OzanE1/CCM7A/Modules/image.png

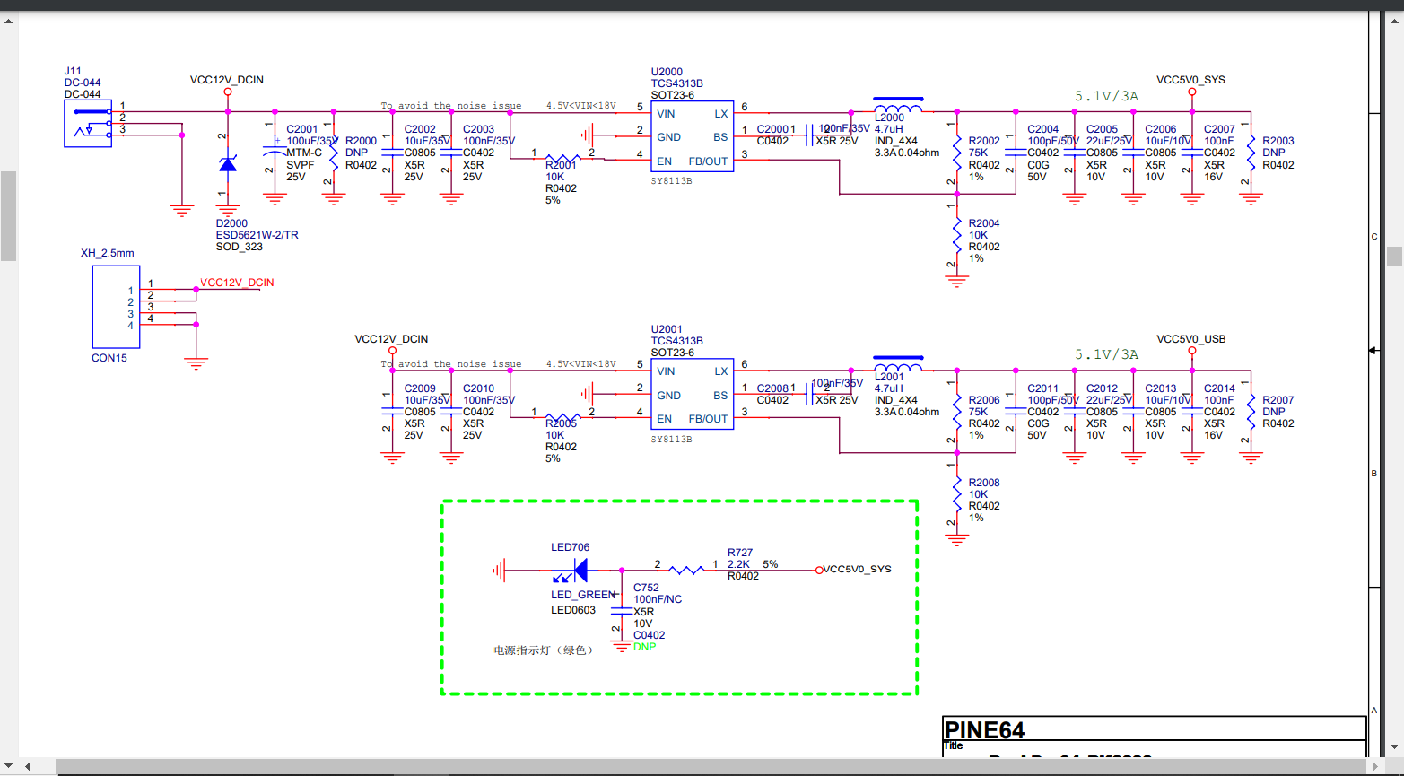
Modules/image.png
