OzanE1/CCM7A/CCM7A_BOM.xlsx

Comment | Designator | Footprint | Part Number
10uF | C1 | Capacitor_SMD:C_0402_1005Metric | C15525
10uF | C53 | Capacitor_SMD:C_0603_1608Metric | C96446
10uF | C34, C35 | Capacitor_SMD:C_0805_2012Metric | C15850
100nF | C2, C3, C4, C5,C6, C7,C8, C9, C10, C11, C12,C14, C16, C19, C22, C23, C24, C25, C33, C38, C41,C42, C43, C48, C52, C54, C55, C56, C57 | Capacitor_SMD:C_0402_1005Metric | C1525
100nF | C51 | Capacitor_SMD:C_0603_1608Metric | C1590
1uF | C13, C15, C36, C39 | Capacitor_SMD:C_0402_1005Metric | C15684
1uF | C30, C45, C46, C50 | Capacitor_SMD:C_0805_2012Metric | C28323
2.2uF | C17, C18 | Capacitor_SMD:C_0402_1005Metric | C12530
8pF | C20, C21, C32, C44 | Capacitor_SMD:C_0402_1005Metric | C1864375
22uF | C26, C27, C49, C60 | Capacitor_SMD:C_0805_2012Metric | C45783
2pF | C28 | Capacitor_SMD:C_0201_0603Metric | C88875
1pF | C29, C58, C61 | Capacitor_SMD:C_0201_0603Metric | C88903
100pF | C31 | Capacitor_SMD:C_0201_0603Metric | C62550
4.7uF | C40 | Capacitor_SMD:C_0603_1608Metric | C1705
33pF | C47 | Capacitor_SMD:C_0402_1005Metric | C107005
10nF | C59 | Capacitor_SMD:C_0402_1005Metric | C60133
1.2pF | C62 | Capacitor_SMD:C_0201_0603Metric | C85895
LED | D2 | LED_SMD:LED_0603_1608Metric | C84256
LED | D3 | LED_SMD:LED_0603_1608Metric | C2286
LED | D4 | LED_SMD:LED_0603_1608Metric | C2290
LED | D5 | LED_SMD:LED_0805_2012Metric | C2297
LED | D6 | LED_SMD:LED_0805_2012Metric | C2296
BAT60B | D9 | Diode_SMD:D_SOD-323 | C7502695
Polyfuse | F1 | Fuse:Fuse_0805_2012Metric | C914092
FerriteBead | FB1 | Inductor_SMD:L_0603_1608Metric | C1002
SRN6045TA-2R2Y | L1 | 6x6mmIND:IND_SRN6045TA-2R2Y | C1332316
4.7nH | L2 | Inductor_SMD:L_0201_0603Metric | C86126
2.2nH | L3 | Inductor_SMD:L_0201_0603Metric | C1329438
1.9nH | L6 | Inductor_SMD:L_0201_0603Metric | C206445
3.0nH | L7 | Inductor_SMD:L_0201_0603Metric | C86111
1.5k | R2, R7, R8, R9, R14, R17 | Resistor_SMD:R_0402_1005Metric | C25867
620R | R3 | Resistor_SMD:R_0402_1005Metric | C4961
4.7k | R1,R4, R5 | Resistor_SMD:R_0402_1005Metric | C25900
10k | R6, R11, R15 | Resistor_SMD:R_0402_1005Metric | C25744
100k | R10 | Resistor_SMD:R_0603_1608Metric | C25803
33.2k | R12 | Resistor_SMD:R_0603_1608Metric | C23003
220k | R13 | Resistor_SMD:R_0603_1608Metric | C22961
50R | R16 | Resistor_SMD:R_0402_1005Metric | C853312
30k | R18 | Resistor_SMD:R_0603_1608Metric | C22984
SKRPABE010 | S1 | SW_SKRPABE010:SW_SKRPABE010 | C115360
STM32H743VGTx | U1 | Package_QFP:LQFP-100_14x14mm_P0.5mm | C730183
24AA64T-I/OT | U2 | Package_TO_SOT_SMD:SOT-23-5_HandSoldering | C2061092
BMI088 | U3 | BMI088:PQFN50P450X300X100-16N | C194919
ICP-20100 | U4 | ICP-20100:PQFN50P200X200X85-10N | C5343527
TXB0104RUT | U5 | Package_DFN_QFN:Texas_R-PUQFN-N12 | C105266
nRF52820-QDxx | U6 | Package_DFN_QFN:QFN-40-1EP_5x5mm_P0.4mm_EP3.6x3.6mm | C3015612
NRF21540-QDAA-R7 | U7 | nRF21540:QFN65P400X400X95-17N | C5357827
TPS566242DRL | U8 | Package_TO_SOT_SMD:SOT-563 | C5219277
ME6211C33M5 | U9, U10 | Package_TO_SOT_SMD:SOT-23-5 | C82942
BMP581 | U11 | LGA-10(2x2) | C5362283
TPS79318-EP | U12 | Package_TO_SOT_SMD:SOT-23-5 | C7102
ICM-20948 | U13 | Sensor_Motion:InvenSense_QFN-24_3x3mm_P0.4mm | C726001
32MHz | Y1, Y2 | Crystal:Crystal_SMD_3225-4Pin_3.2x2.5mm | C426985
