OzanE1/CCM7A/CC_M7.pdf

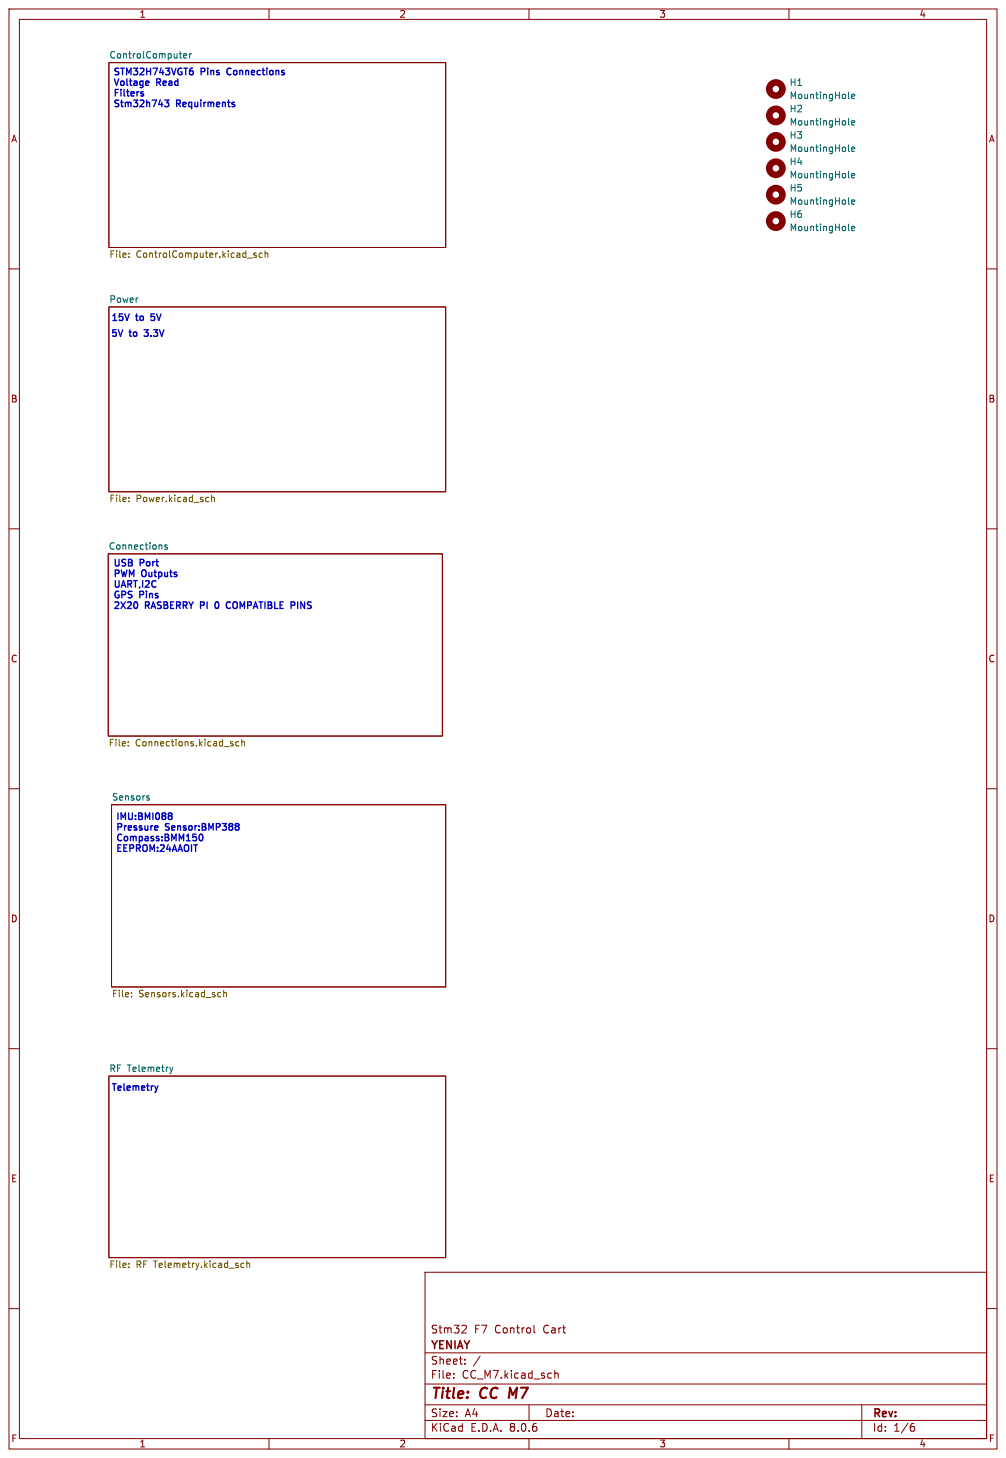
[picture p3: page 1]

STM32H743VGT6 Pins Connections Voltage Read

5V to 3.3V USB Port PWM Outputs
Sensors File: Sensors.kicad_sch Connections File: Connections.kicad_sch

2X20 RASBERRY PI 0 COMPATIBLE PINS

IMU:BMI088 Pressure Sensor:BMP388 Compass:BMM150 EEPROM:24AAOIT

Stm32 F7 Control Cart RF Telemetry File: RF Telemetry.kicad_sch
Telemetry

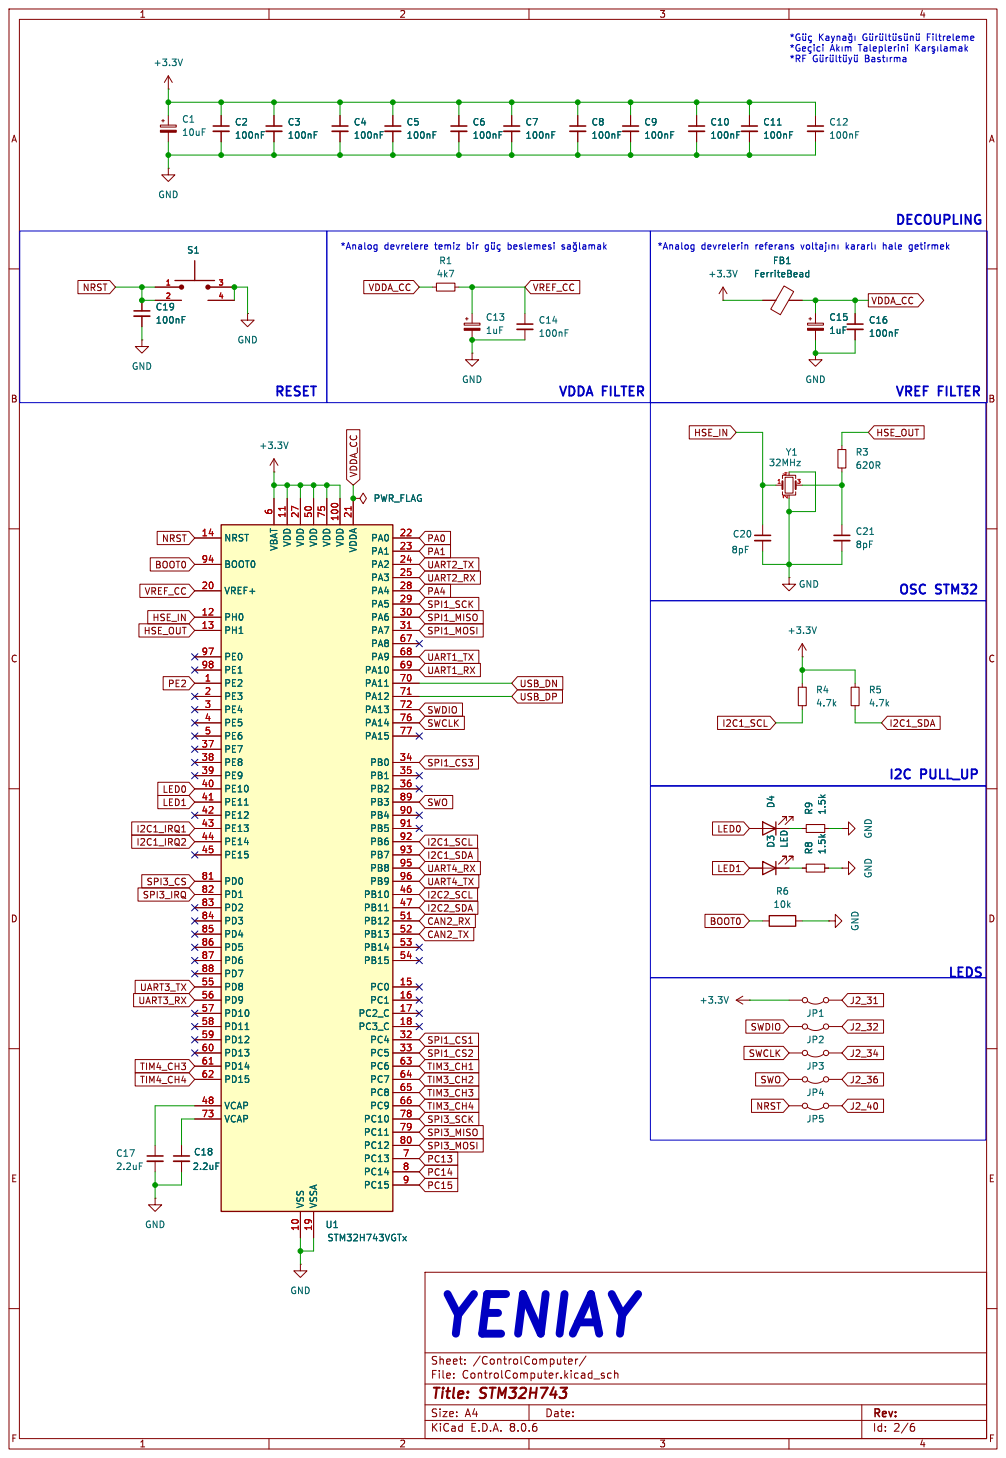
[picture p4: page 2]

þÿ*Güç þÿKayna1 þÿGürültüsünü Filtreleme

File: ControlComputer.kicad_sch Sheet: /ControlComputer/
Id: 2/6 Title: STM32H743

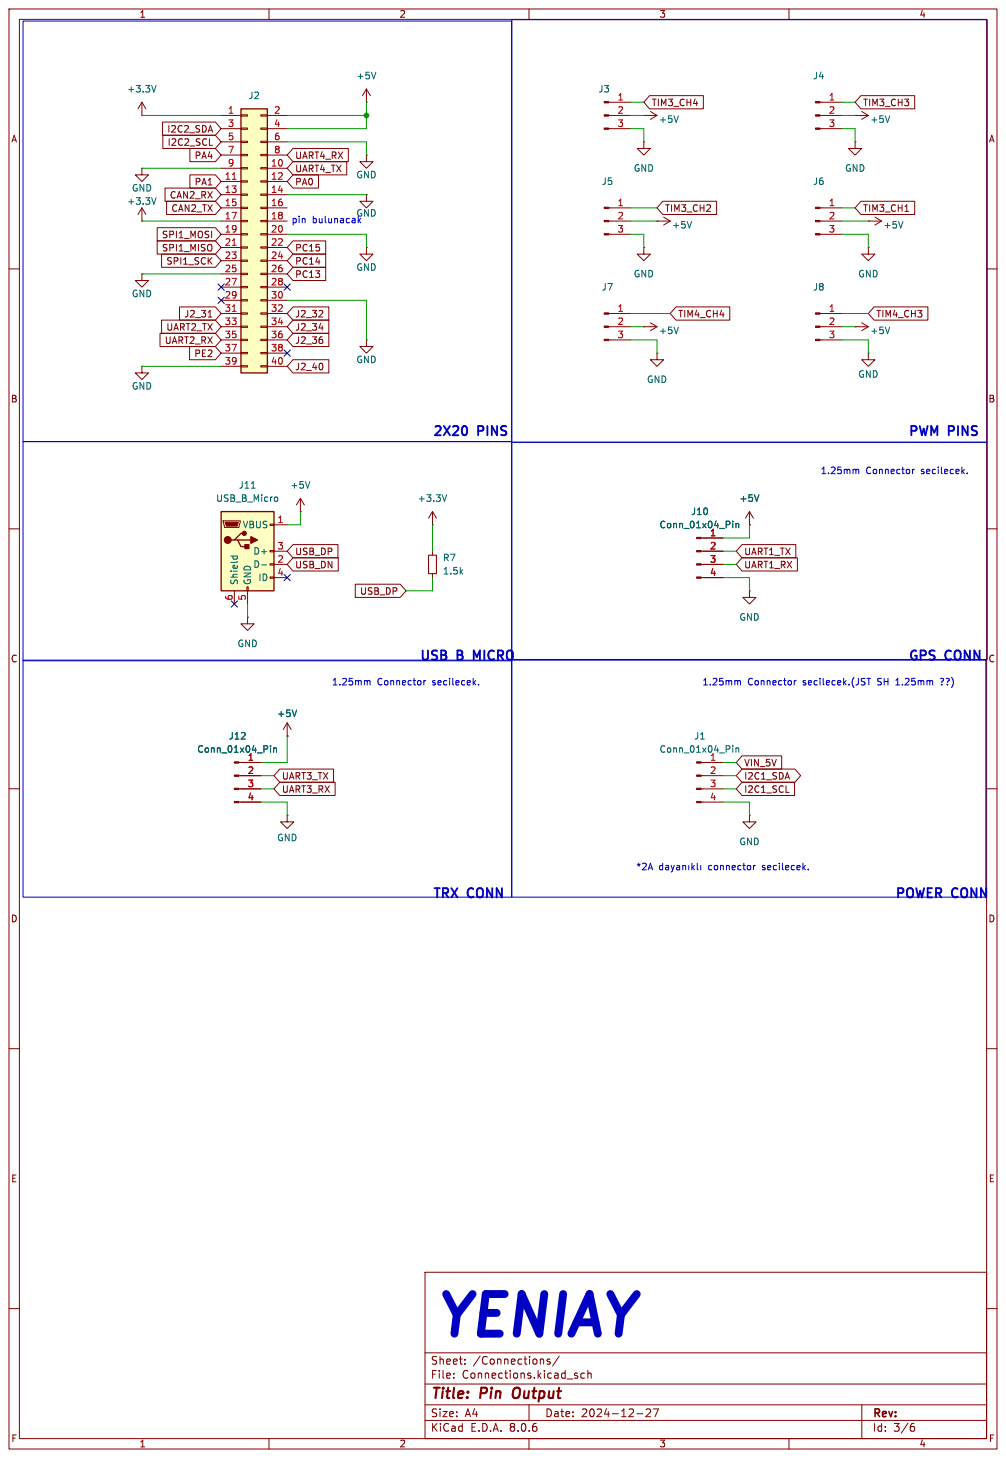
[picture p5: page 3]

Id: 3/6 Title: Pin Output File: Connections.kicad_sch Sheet: /Connections/

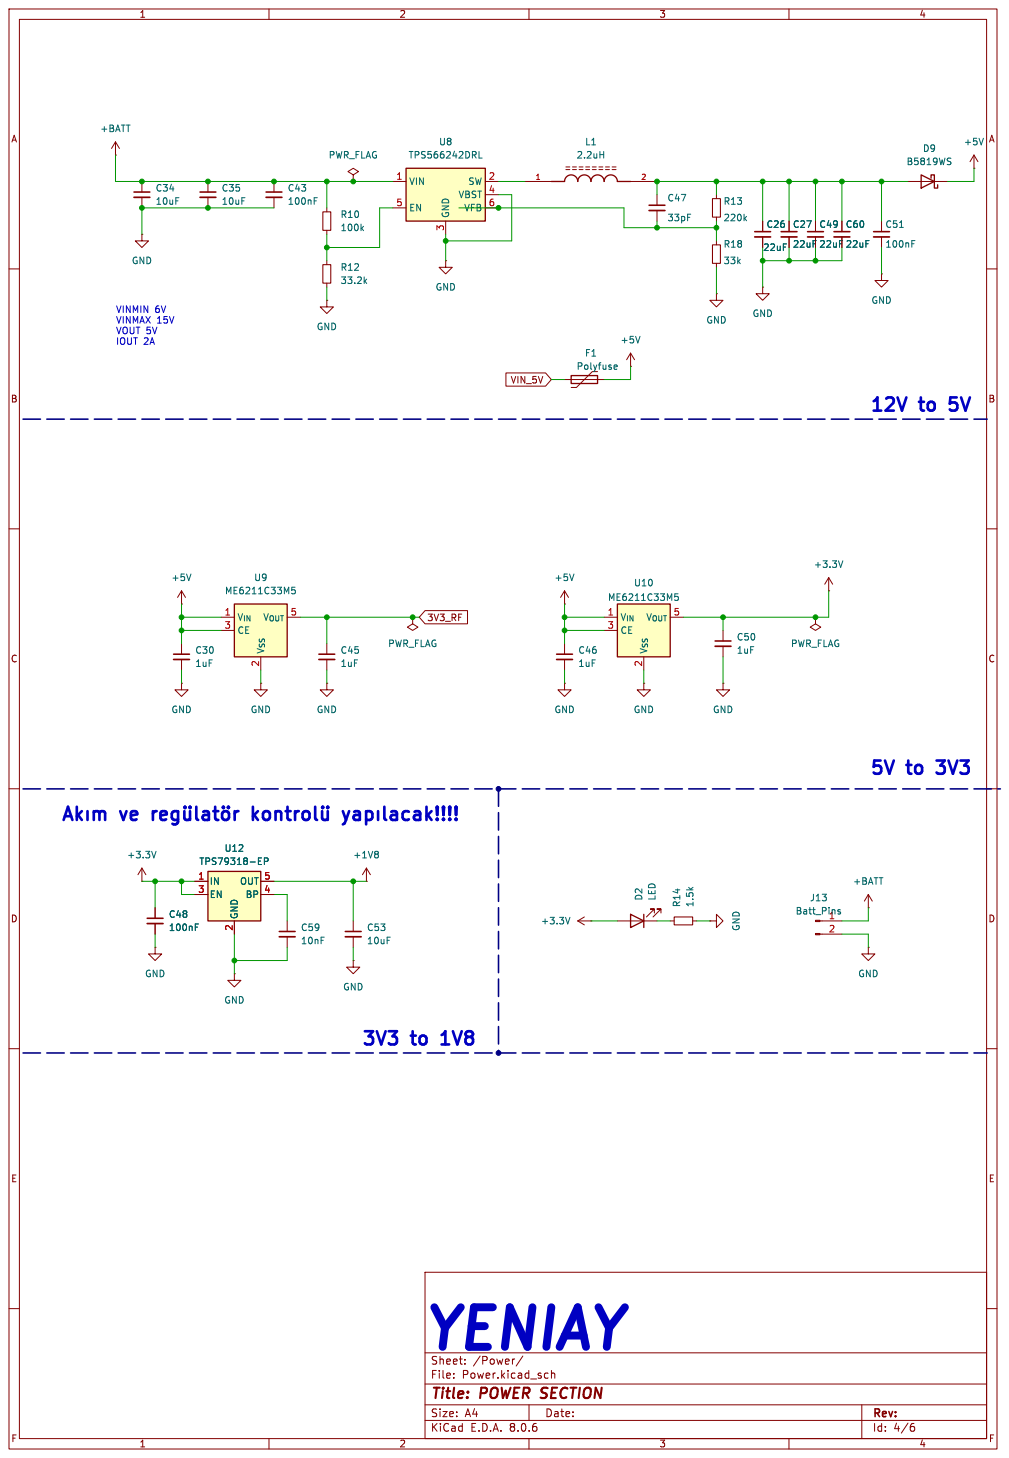
[picture p6: page 4]

2 EN 3 BP 4 OUT 5 U12 TPS79318-EP

Id: 4/6 Title: POWER SECTION

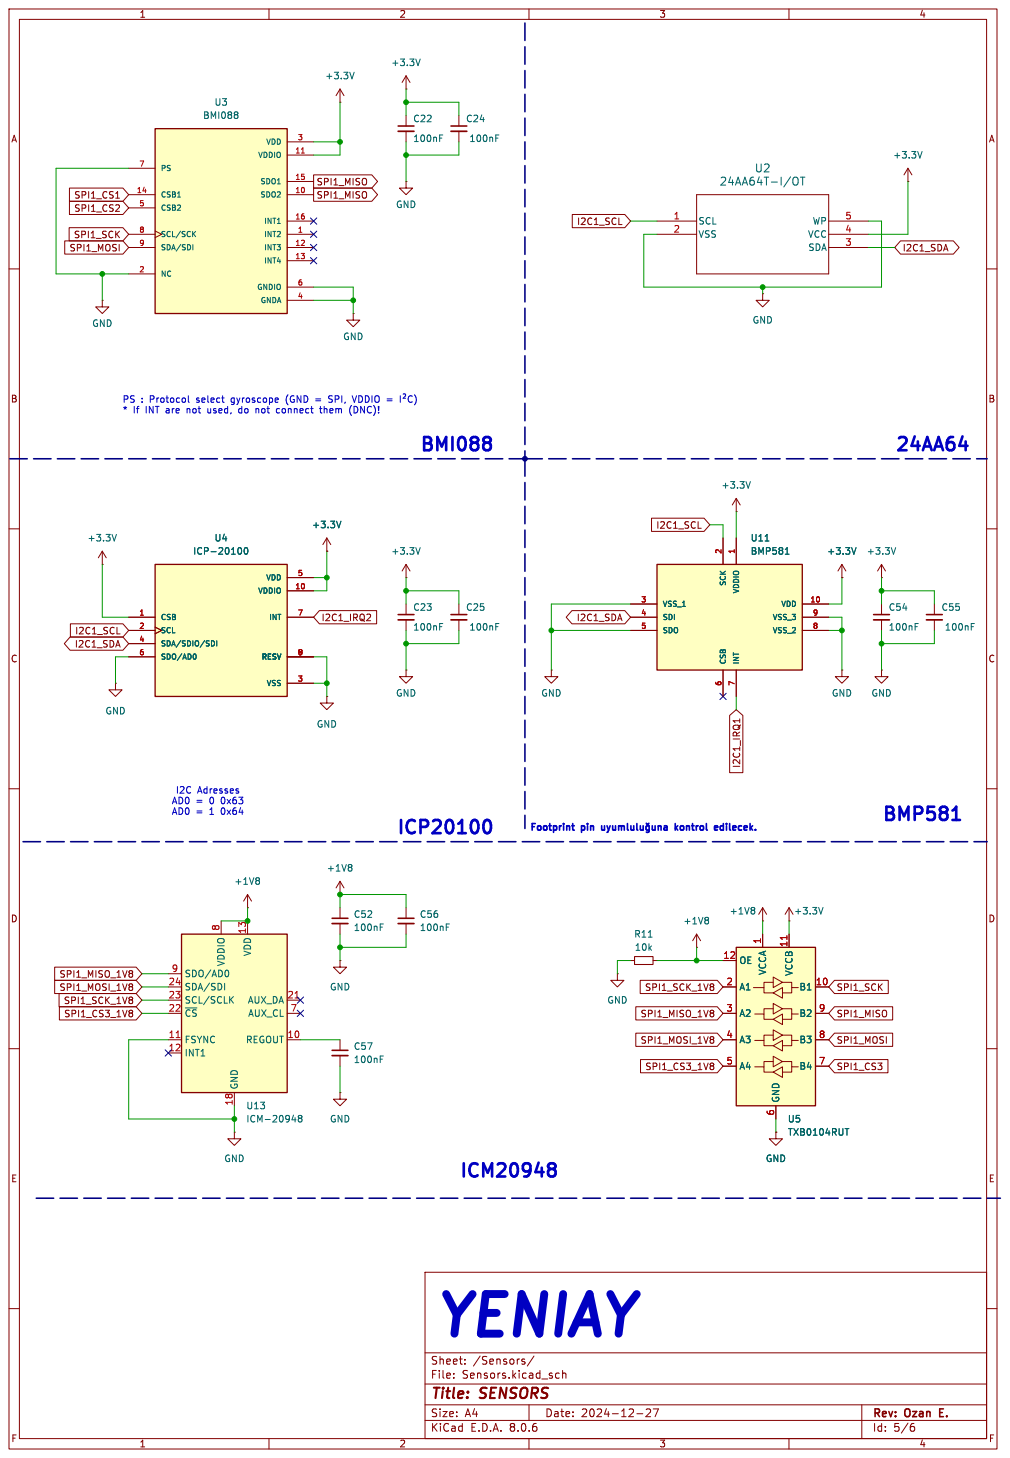
[picture p7: page 5]

Footprint pin þÿuyumluluuna kotrol edilecek. U4

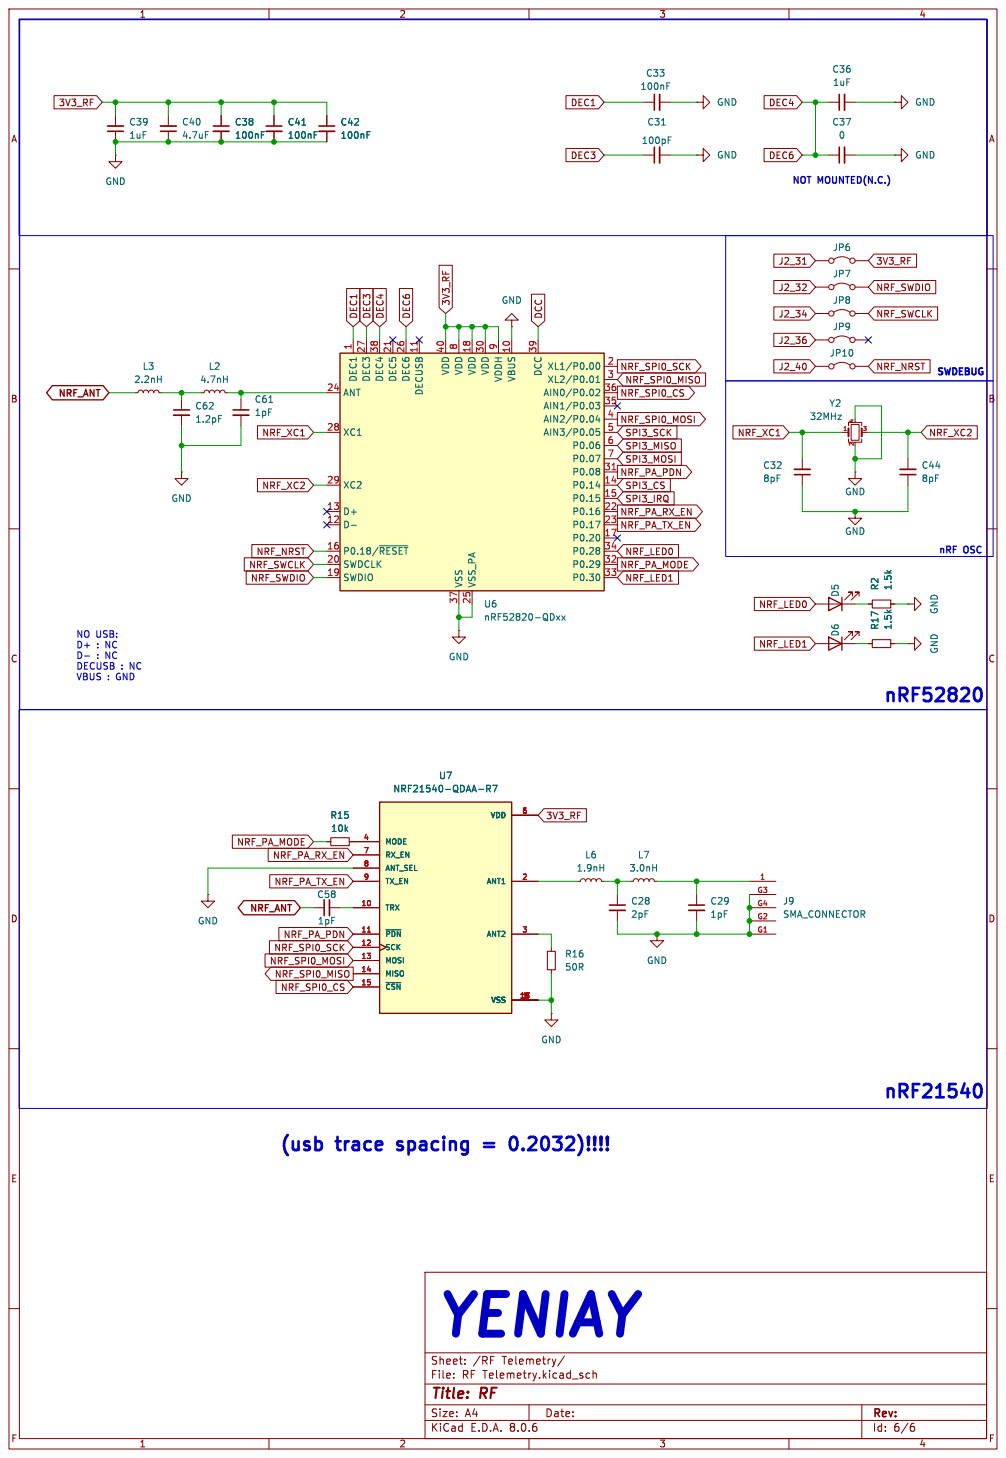
[picture p8: page 6]

1 VBUS 10 DECUSB 11 D- 12 D+ 13 P0.14 14 P0.15 15 P0.18/~{RESET} 16 P0.20 17 VDD 18 SWDIO 19 XL1/P0.00 2 SWDCLK 20 DEC5 21 P0.16 22 P0.17 23 ANT 24 VSS_PA 25 DEC6 26 DEC3 27 XC1 28 XC2 29 XL2/P0.01 VDD 3 30 P0.08 31 P0.29 32 P0.30 33 P0.28 34 AIN1/P0.03 35 AIN0/P0.02 36 VSS 37 DEC4 38 DCC 39 AIN2/P0.04 4 VDD 40 AIN3/P0.05 5 P0.06 6 P0.07 7 VDD
