OzanE1/CCM7A/CC_M7/CC_M7.kicad_pcb

## KiCad design CC_M7/CC_M7.kicad_pcb (2025-06-05)

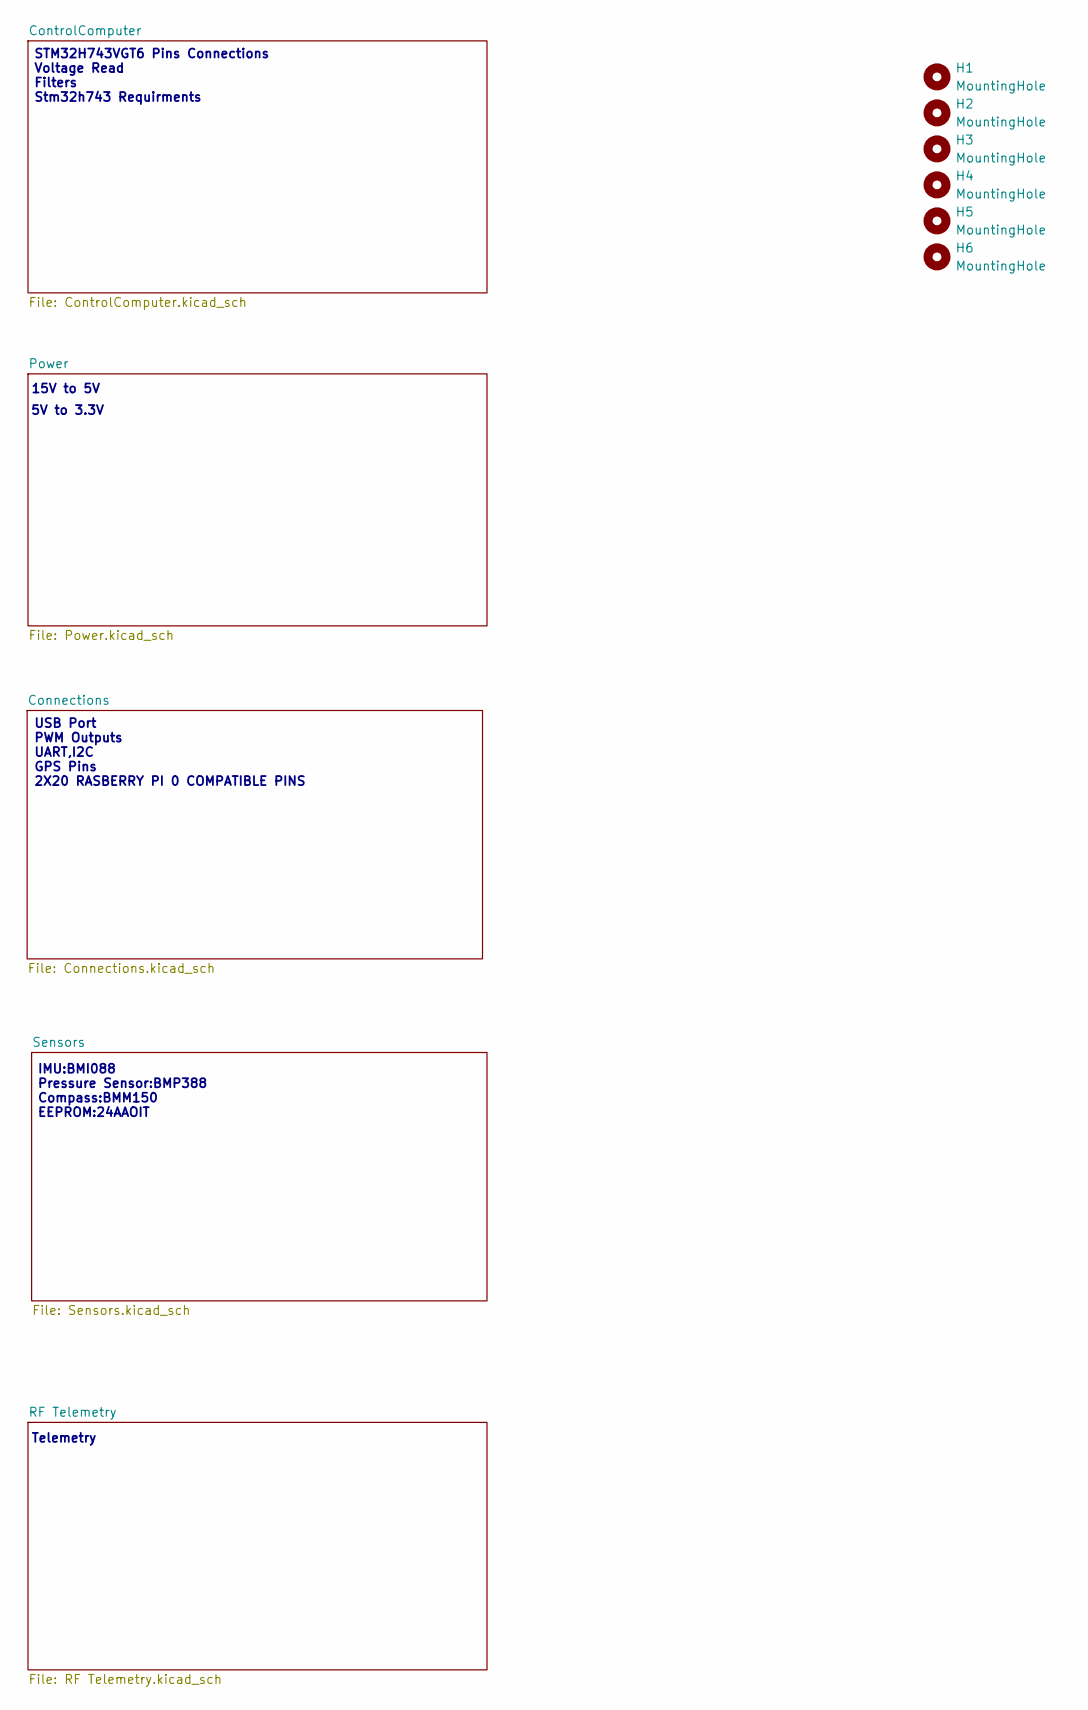
[picture p9: schematic CC_M7.kicad_sch, CC M7]

Parts:
H1, H2, H3, H4, H5, H6: MountingHole; CCMountingHole

Notes on the sheet:
15V to 5V
5V to 3.3V
USB Port PWM Outputs UART,I2C GPS Pins 2X20 RASBERRY PI 0 COMPATIBLE PINS
Telemetry
STM32H743VGT6 Pins Connections Voltage Read Filters Stm32h743 Requirments
IMU:BMI088 Pressure Sensor:BMP388 Compass:BMM150 EEPROM:24AAOIT

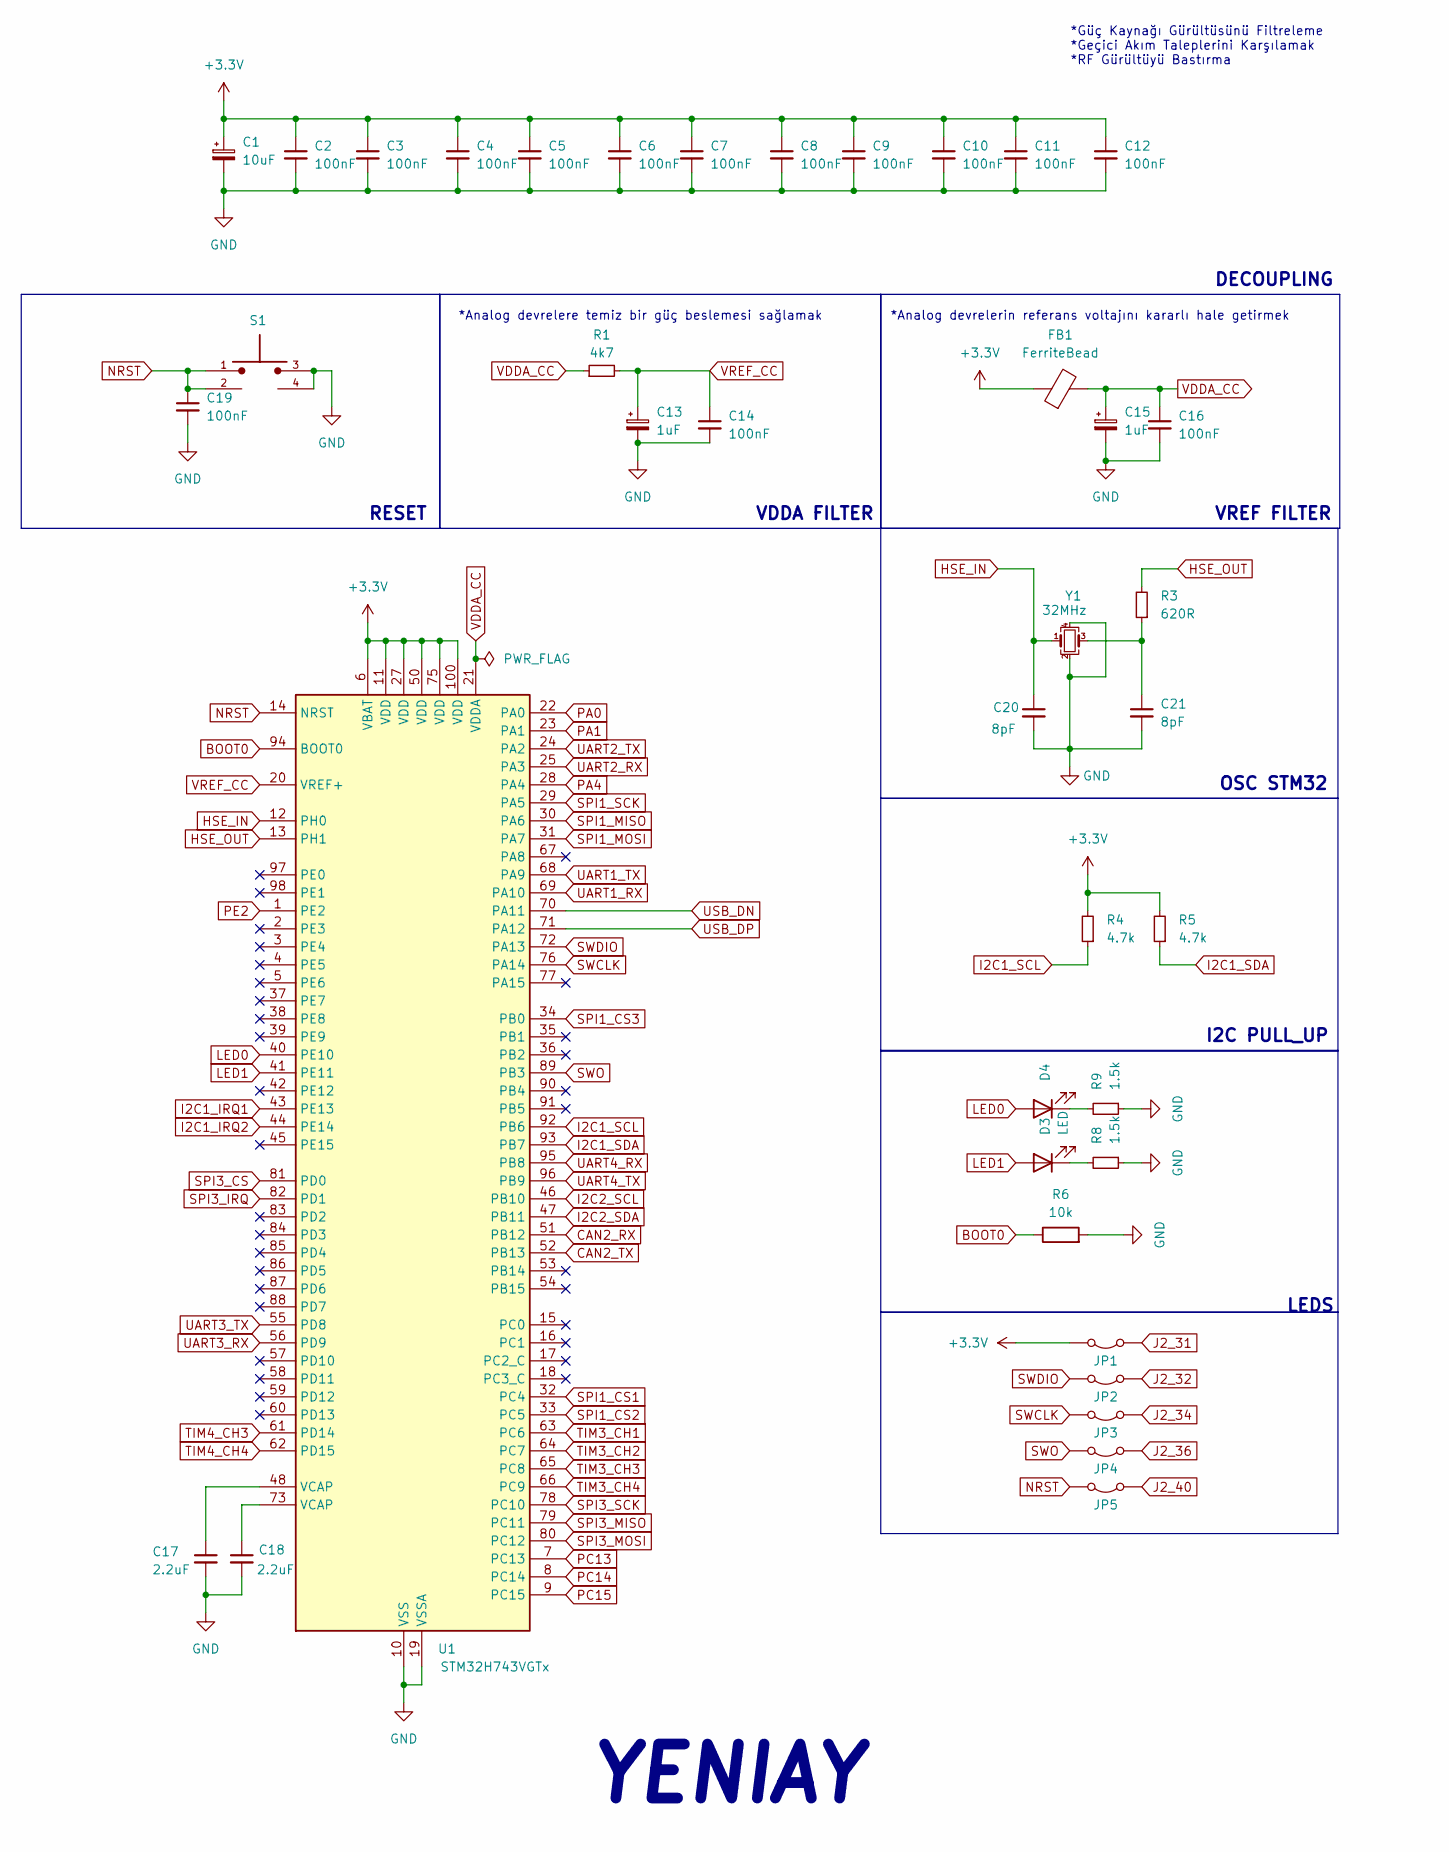
[picture p10: schematic ControlComputer.kicad_sch, STM32H743]

Parts:
C1: 10uF; C_0402_1005Metric
C2, C3, C4, C5, C6, C7, C8, C9, C10, C11, C12, C14, C16, C19: 100nF; C_0402_1005Metric
C13, C15: 1uF; C_0402_1005Metric
C17, C18: 2.2uF; C_0402_1005Metric
C20, C21: 8pF; C_0402_1005Metric
D3, D4: LED; LED_0603_1608Metric
FB1: FerriteBead; L_0603_1608Metric
JP1, JP2, JP3, JP4, JP5: SWDIO; SolderJumper-2_P1.3mm_Open_TrianglePad1.0x1.5mm
R1: 4k7; R_0402_1005Metric
R3: 620R; R_0402_1005Metric
R4, R5: 4.7k; R_0402_1005Metric
R6: 10k; R_0402_1005Metric
R8, R9: 1.5k; R_0402_1005Metric
S1: SKRPABE010; SW_SKRPABE010
U1: STM32H743VGTx; LQFP-100_14x14mm_P0.5mm
Y1: 32MHz; Crystal_SMD_3225-4Pin_3.2x2.5mm

Connections:
+3.3V: C1.1, C2.1, C3.1, C4.1, C5.1, C6.1, C7.1, C8.1, C9.1, C10.1, C11.1, C12.1, FB1.1, JP1.2 (B), R4.2, R5.2, U1.6 (VBAT), U1.11 (VDD), U1.27 (VDD), U1.50 (VDD), U1.75 (VDD), U1.100 (VDD); also elsewhere on the board
BOOT0: R6.1, U1.94 (BOOT0)
CAN2_RX: U1.51 (PB12); also elsewhere on the board
CAN2_TX: U1.52 (PB13); also elsewhere on the board
GND: C1.2, C2.2, C3.2, C4.2, C5.2, C6.2, C7.2, C8.2, C9.2, C10.2, C11.2, C12.2, C13.2, C14.2, C15.2, C16.2, C17.2, C18.2, C19.2, C20.2, C21.2, R6.2, R8.1, R9.1, S1.3, S1.4, U1.10 (VSS), U1.19 (VSSA), U1.26 (VSS), U1.49 (VSS), U1.74 (VSS), U1.99 (VSS), Y1.2, Y1.4; also elsewhere on the board
HSE_IN: C20.1, U1.12 (PH0), Y1.1
HSE_OUT: R3.2, U1.13 (PH1)
I2C1_IRQ1: U1.43 (PE13); also elsewhere on the board
I2C1_IRQ2: U1.44 (PE14); also elsewhere on the board
I2C1_SCL: R4.1, U1.92 (PB6); also elsewhere on the board
I2C1_SDA: R5.1, U1.93 (PB7); also elsewhere on the board
I2C2_SCL: U1.46 (PB10); also elsewhere on the board
I2C2_SDA: U1.47 (PB11); also elsewhere on the board
J2_31: JP1.1 (A); also elsewhere on the board
J2_32: JP2.1 (A); also elsewhere on the board
J2_34: JP3.1 (A); also elsewhere on the board
J2_36: JP4.1 (A); also elsewhere on the board
J2_40: JP5.1 (A); also elsewhere on the board
LED0: D4.2 (A), U1.40 (PE10)
LED1: D3.2 (A), U1.41 (PE11)
NRST: C19.1, JP5.2 (B), S1.1, S1.2, U1.14 (NRST)
unnamed: C17.1, U1.48 (VCAP)
unnamed: C18.1, U1.73 (VCAP)
unnamed: C21.1, R3.1, Y1.3
unnamed: D3.1 (K), R8.2
unnamed: D4.1 (K), R9.2
PA0: U1.22 (PA0); also elsewhere on the board
PA1: U1.23 (PA1); also elsewhere on the board
PA4: U1.28 (PA4); also elsewhere on the board
PC13: U1.7 (PC13); also elsewhere on the board
PC14: U1.8 (PC14); also elsewhere on the board
PC15: U1.9 (PC15); also elsewhere on the board
PE2: U1.1 (PE2); also elsewhere on the board
SPI1_CS1: U1.32 (PC4); also elsewhere on the board
SPI1_CS2: U1.33 (PC5); also elsewhere on the board
SPI1_CS3: U1.34 (PB0); also elsewhere on the board
SPI1_MISO: U1.30 (PA6); also elsewhere on the board
SPI1_MOSI: U1.31 (PA7); also elsewhere on the board
SPI1_SCK: U1.29 (PA5); also elsewhere on the board
SPI3_CS: U1.81 (PD0); also elsewhere on the board
SPI3_IRQ: U1.82 (PD1); also elsewhere on the board
SPI3_MISO: U1.79 (PC11); also elsewhere on the board
SPI3_MOSI: U1.80 (PC12); also elsewhere on the board
SPI3_SCK: U1.78 (PC10); also elsewhere on the board
SWCLK: JP3.2 (B), U1.76 (PA14)
SWDIO: JP2.2 (B), U1.72 (PA13)
SWO: JP4.2 (B), U1.89 (PB3)
TIM3_CH1: U1.63 (PC6); also elsewhere on the board
TIM3_CH2: U1.64 (PC7); also elsewhere on the board
TIM3_CH3: U1.65 (PC8); also elsewhere on the board
TIM3_CH4: U1.66 (PC9); also elsewhere on the board
TIM4_CH3: U1.61 (PD14); also elsewhere on the board
TIM4_CH4: U1.62 (PD15); also elsewhere on the board
UART1_RX: U1.69 (PA10); also elsewhere on the board
UART1_TX: U1.68 (PA9); also elsewhere on the board
UART2_RX: U1.25 (PA3); also elsewhere on the board
UART2_TX: U1.24 (PA2); also elsewhere on the board
UART3_RX: U1.56 (PD9); also elsewhere on the board
UART3_TX: U1.55 (PD8); also elsewhere on the board
UART4_RX: U1.95 (PB8); also elsewhere on the board
UART4_TX: U1.96 (PB9); also elsewhere on the board
USB_DN: U1.70 (PA11); also elsewhere on the board
USB_DP: U1.71 (PA12); also elsewhere on the board
VDDA_CC: C15.1, C16.1, FB1.2, R1.1, U1.21 (VDDA)
VREF_CC: C13.1, C14.1, R1.2, U1.20 (VREF+)

Notes on the sheet:
*Güç Kaynağı Gürültüsünü Filtreleme *Geçici Akım Taleplerini Karşılamak *RF Gürültüyü Bastırma
*Analog devrelere temiz bir güç beslemesi sağlamak
DECOUPLING
OSC STM32
VREF FILTER
RESET
I2C PULL_UP
*Analog devrelerin referans voltajını kararlı hale getirmek
LEDS
YENIAY
VDDA FILTER

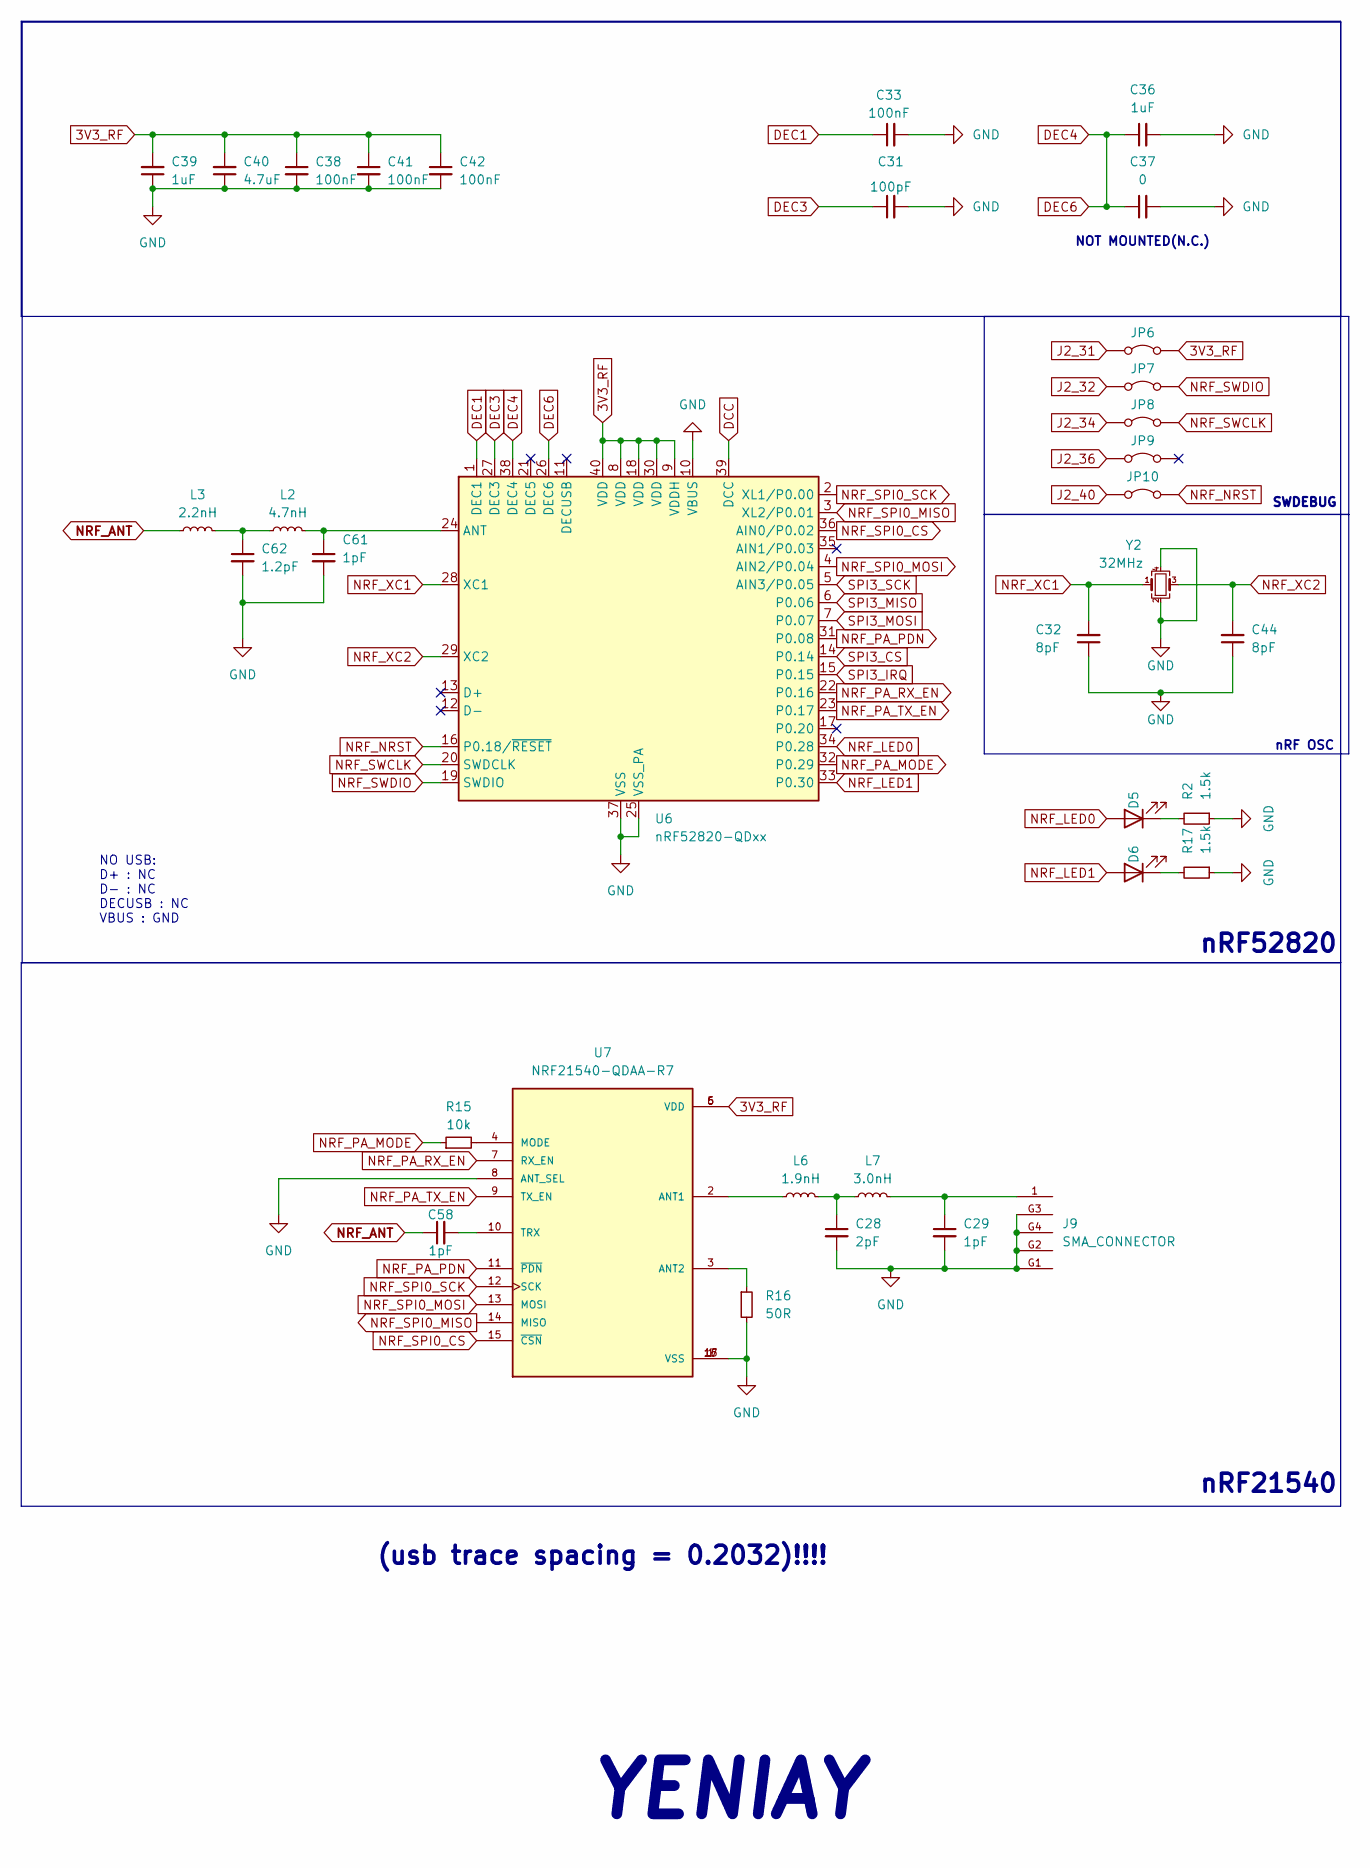
[picture p11: schematic RF Telemetry.kicad_sch, RF]

Parts:
C28: 2pF; C_0201_0603Metric
C29, C58, C61: 1pF; C_0201_0603Metric
C31: 100pF; C_0402_1005Metric
C32, C44: 8pF; C_0402_1005Metric
C33, C38, C41, C42: 100nF; C_0402_1005Metric
C36, C39: 1uF; C_0402_1005Metric
C37: 0; C_0402_1005Metric
C40: 4.7uF; C_0603_1608Metric
C62: 1.2pF; C_0201_0603Metric
D5, D6: LED; LED_0805_2012Metric
J9: SMA_CONNECTOR; LPRS_SMA_CONNECTOR; PARTREV 1.3
JP6, JP7, JP8, JP9, JP10: SWDIO; SolderJumper-2_P1.3mm_Open_TrianglePad1.0x1.5mm
L2: 4.7nH; L_0201_0603Metric
L3: 2.2nH; L_0201_0603Metric
L6: 1.9nH; L_0201_0603Metric
L7: 3.0nH; L_0201_0603Metric
R2, R17: 1.5k; R_0402_1005Metric
R15: 10k; R_0402_1005Metric
R16: 50R; R_0402_1005Metric
U6: nRF52820-QDxx; QFN-40-1EP_5x5mm_P0.4mm_EP3.6x3.6mm
U7: NRF21540-QDAA-R7; QFN65P400X400X95-17N; PARTREV 1.0
Y2: 32MHz; Crystal_SMD_3225-4Pin_3.2x2.5mm

Connections:
3V3_RF: C38.1, C39.2, C40.2, C41.1, C42.1, JP6.2 (B), U6.8 (VDD), U6.9 (VDDH), U6.18 (VDD), U6.30 (VDD), U6.40 (VDD), U7.5 (VDD), U7.6 (VDD); also elsewhere on the board
DCC: U6.39 (DCC)
DEC1: C33.1, U6.1 (DEC1)
DEC3: C31.1, U6.27 (DEC3)
DEC4: C36.1, C37.1, U6.26 (DEC6), U6.38 (DEC4)
GND: C28.2, C29.2, C31.2, C32.1, C33.2, C36.2, C37.2, C38.2, C39.1, C40.1, C41.2, C42.2, C44.1, C61.2, C62.2, J9.G1, J9.G2, J9.G3, J9.G4, R2.1, R16.2, R17.1, U6.10 (VBUS), U6.25 (VSS_PA), U6.37 (VSS), U6.41 (VSS), U7.1 (VSS), U7.8 (ANT_SEL), U7.16 (VSS), U7.17 (VSS), Y2.2, Y2.4; also elsewhere on the board
J2_31: JP6.1 (A); also elsewhere on the board
J2_32: JP7.1 (A); also elsewhere on the board
J2_34: JP8.1 (A); also elsewhere on the board
J2_36: JP9.1 (A); also elsewhere on the board
J2_40: JP10.1 (A); also elsewhere on the board
NRF_ANT: C58.1, L3.1
NRF_LED0: D5.2 (A), U6.34 (P0.28)
NRF_LED1: D6.2 (A), U6.33 (P0.30)
NRF_NRST: JP10.2 (B), U6.16 (P0.18/~RESET)
NRF_PA_MODE: R15.1, U6.32 (P0.29)
NRF_PA_PDN: U6.31 (P0.08), U7.11 (~PDN)
NRF_PA_RX_EN: U6.22 (P0.16), U7.7 (RX_EN)
NRF_PA_TX_EN: U6.23 (P0.17), U7.9 (TX_EN)
NRF_SPI0_CS: U6.36 (AIN0/P0.02), U7.15 (~CSN)
NRF_SPI0_MISO: U6.3 (XL2/P0.01), U7.14 (MISO)
NRF_SPI0_MOSI: U6.4 (AIN2/P0.04), U7.13 (MOSI)
NRF_SPI0_SCK: U6.2 (XL1/P0.00), U7.12 (SCK)
NRF_SWCLK: JP8.2 (B), U6.20 (SWDCLK)
NRF_SWDIO: JP7.2 (B), U6.19 (SWDIO)
NRF_XC1: C32.2, U6.28 (XC1), Y2.1
NRF_XC2: C44.2, U6.29 (XC2), Y2.3
unnamed: C28.1, L6.2, L7.1
unnamed: C29.1, J9.1, L7.2
unnamed: C62.1, L2.1, L3.2
unnamed: D5.1 (K), R2.2
unnamed: D6.1 (K), R17.2
unnamed: C61.1, L2.2, U6.24 (ANT)
unnamed: L6.1, U7.2 (ANT1)
unnamed: R16.1, U7.3 (ANT2)
unnamed: R15.2, U7.4 (MODE)
unnamed: C58.2, U7.10 (TRX)
SPI3_CS: U6.14 (P0.14); also elsewhere on the board
SPI3_IRQ: U6.15 (P0.15); also elsewhere on the board
SPI3_MISO: U6.6 (P0.06); also elsewhere on the board
SPI3_MOSI: U6.7 (P0.07); also elsewhere on the board
SPI3_SCK: U6.5 (AIN3/P0.05); also elsewhere on the board

Notes on the sheet:
NO USB: D+ : NC D- : NC DECUSB : NC VBUS : GND
(usb trace spacing = 0.2032)!!!!
nRF21540
nRF52820
YENIAY
NOT MOUNTED(N.C.)
nRF OSC
SWDEBUG

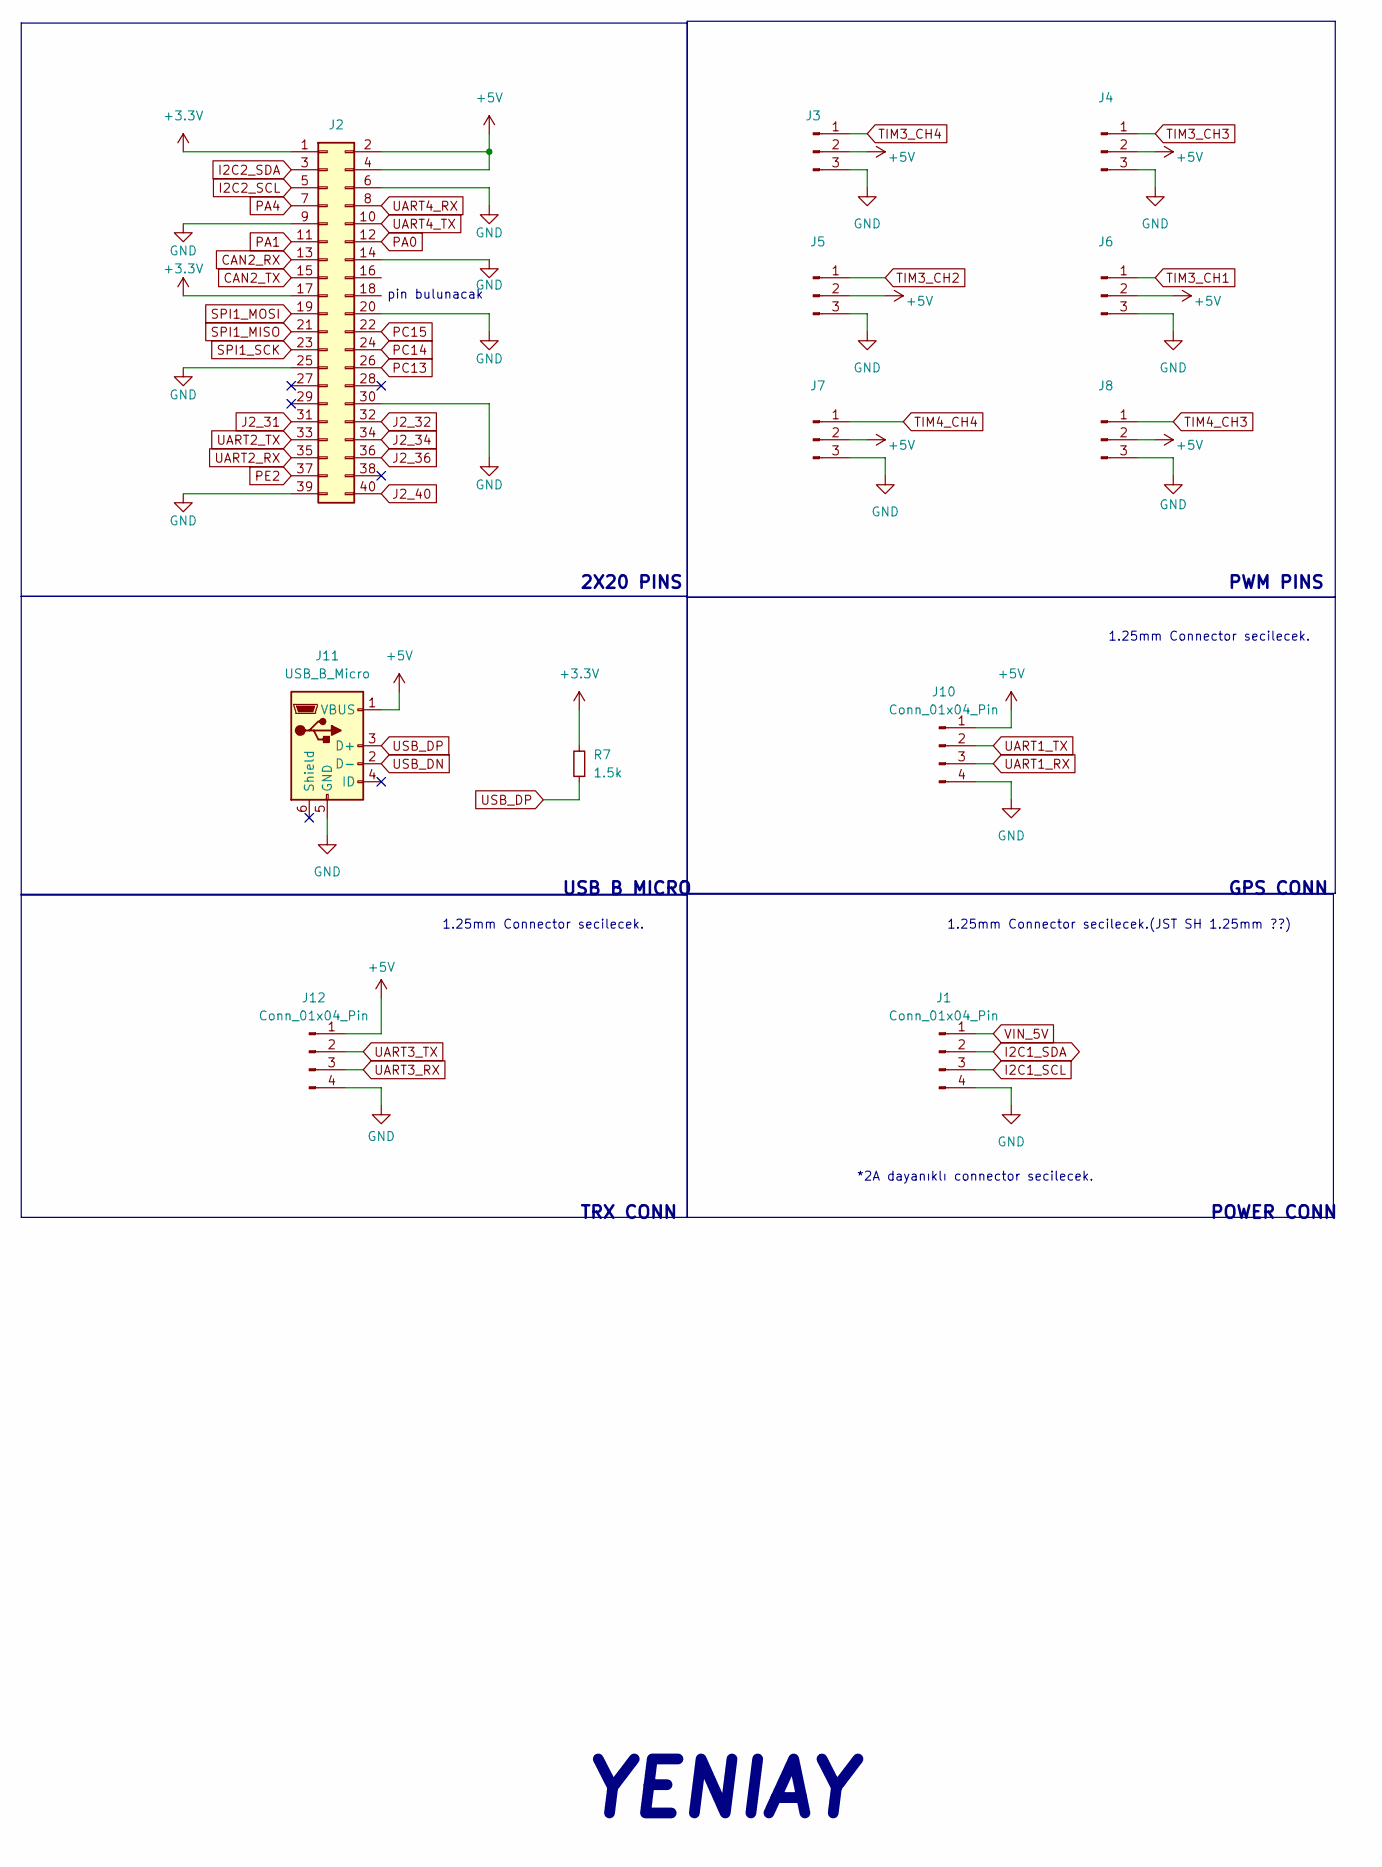
[picture p12: schematic Connections.kicad_sch, Pin Output]

Parts:
J1, J10, J12: Conn_01x04_Pin; Hirose_DF13-04P-1.25DSA_1x04_P1.25mm_Vertical
J2: IDC-Header_2x20_P2.54mm_Vertical
J3, J4, J5, J6, J7, J8: Conn_01x03_Pin; 1x03_2.54vertical
J11: USB_B_Micro; USB_Micro-B_Wuerth_629105150521
R7: 1.5k; R_0402_1005Metric

Connections:
+3.3V: J2.1, J2.17, R7.2; also elsewhere on the board
+5V: J2.2, J2.4, J3.2, J4.2, J5.2, J6.2, J7.2, J8.2, J10.1, J11.1 (VBUS), J12.1; also elsewhere on the board
CAN2_RX: J2.13; also elsewhere on the board
CAN2_TX: J2.15; also elsewhere on the board
GND: J1.4, J2.6, J2.9, J2.14, J2.20, J2.25, J2.30, J2.39, J3.3, J4.3, J5.3, J6.3, J7.3, J8.3, J10.4, J11.5 (GND), J12.4; also elsewhere on the board
I2C1_SCL: J1.3; also elsewhere on the board
I2C1_SDA: J1.2; also elsewhere on the board
I2C2_SCL: J2.5; also elsewhere on the board
I2C2_SDA: J2.3; also elsewhere on the board
J2_31: J2.31; also elsewhere on the board
J2_32: J2.32; also elsewhere on the board
J2_34: J2.34; also elsewhere on the board
J2_36: J2.36; also elsewhere on the board
J2_40: J2.40; also elsewhere on the board
PA0: J2.12; also elsewhere on the board
PA1: J2.11; also elsewhere on the board
PA4: J2.7; also elsewhere on the board
PC13: J2.26; also elsewhere on the board
PC14: J2.24; also elsewhere on the board
PC15: J2.22; also elsewhere on the board
PE2: J2.37; also elsewhere on the board
SPI1_MISO: J2.21; also elsewhere on the board
SPI1_MOSI: J2.19; also elsewhere on the board
SPI1_SCK: J2.23; also elsewhere on the board
TIM3_CH1: J6.1; also elsewhere on the board
TIM3_CH2: J5.1; also elsewhere on the board
TIM3_CH3: J4.1; also elsewhere on the board
TIM3_CH4: J3.1; also elsewhere on the board
TIM4_CH3: J8.1; also elsewhere on the board
TIM4_CH4: J7.1; also elsewhere on the board
UART1_RX: J10.3; also elsewhere on the board
UART1_TX: J10.2; also elsewhere on the board
UART2_RX: J2.35; also elsewhere on the board
UART2_TX: J2.33; also elsewhere on the board
UART3_RX: J12.3; also elsewhere on the board
UART3_TX: J12.2; also elsewhere on the board
UART4_RX: J2.8; also elsewhere on the board
UART4_TX: J2.10; also elsewhere on the board
USB_DN: J11.2 (D-); also elsewhere on the board
USB_DP: J11.3 (D+), R7.1; also elsewhere on the board
VIN_5V: J1.1; also elsewhere on the board

Notes on the sheet:
YENIAY
POWER CONN
pin bulunacak
PWM PINS
GPS CONN
1.25mm Connector secilecek.
*2A dayanıklı connector secilecek.
TRX CONN
2X20 PINS
1.25mm Connector secilecek.(JST SH 1.25mm ??)
USB B MICRO

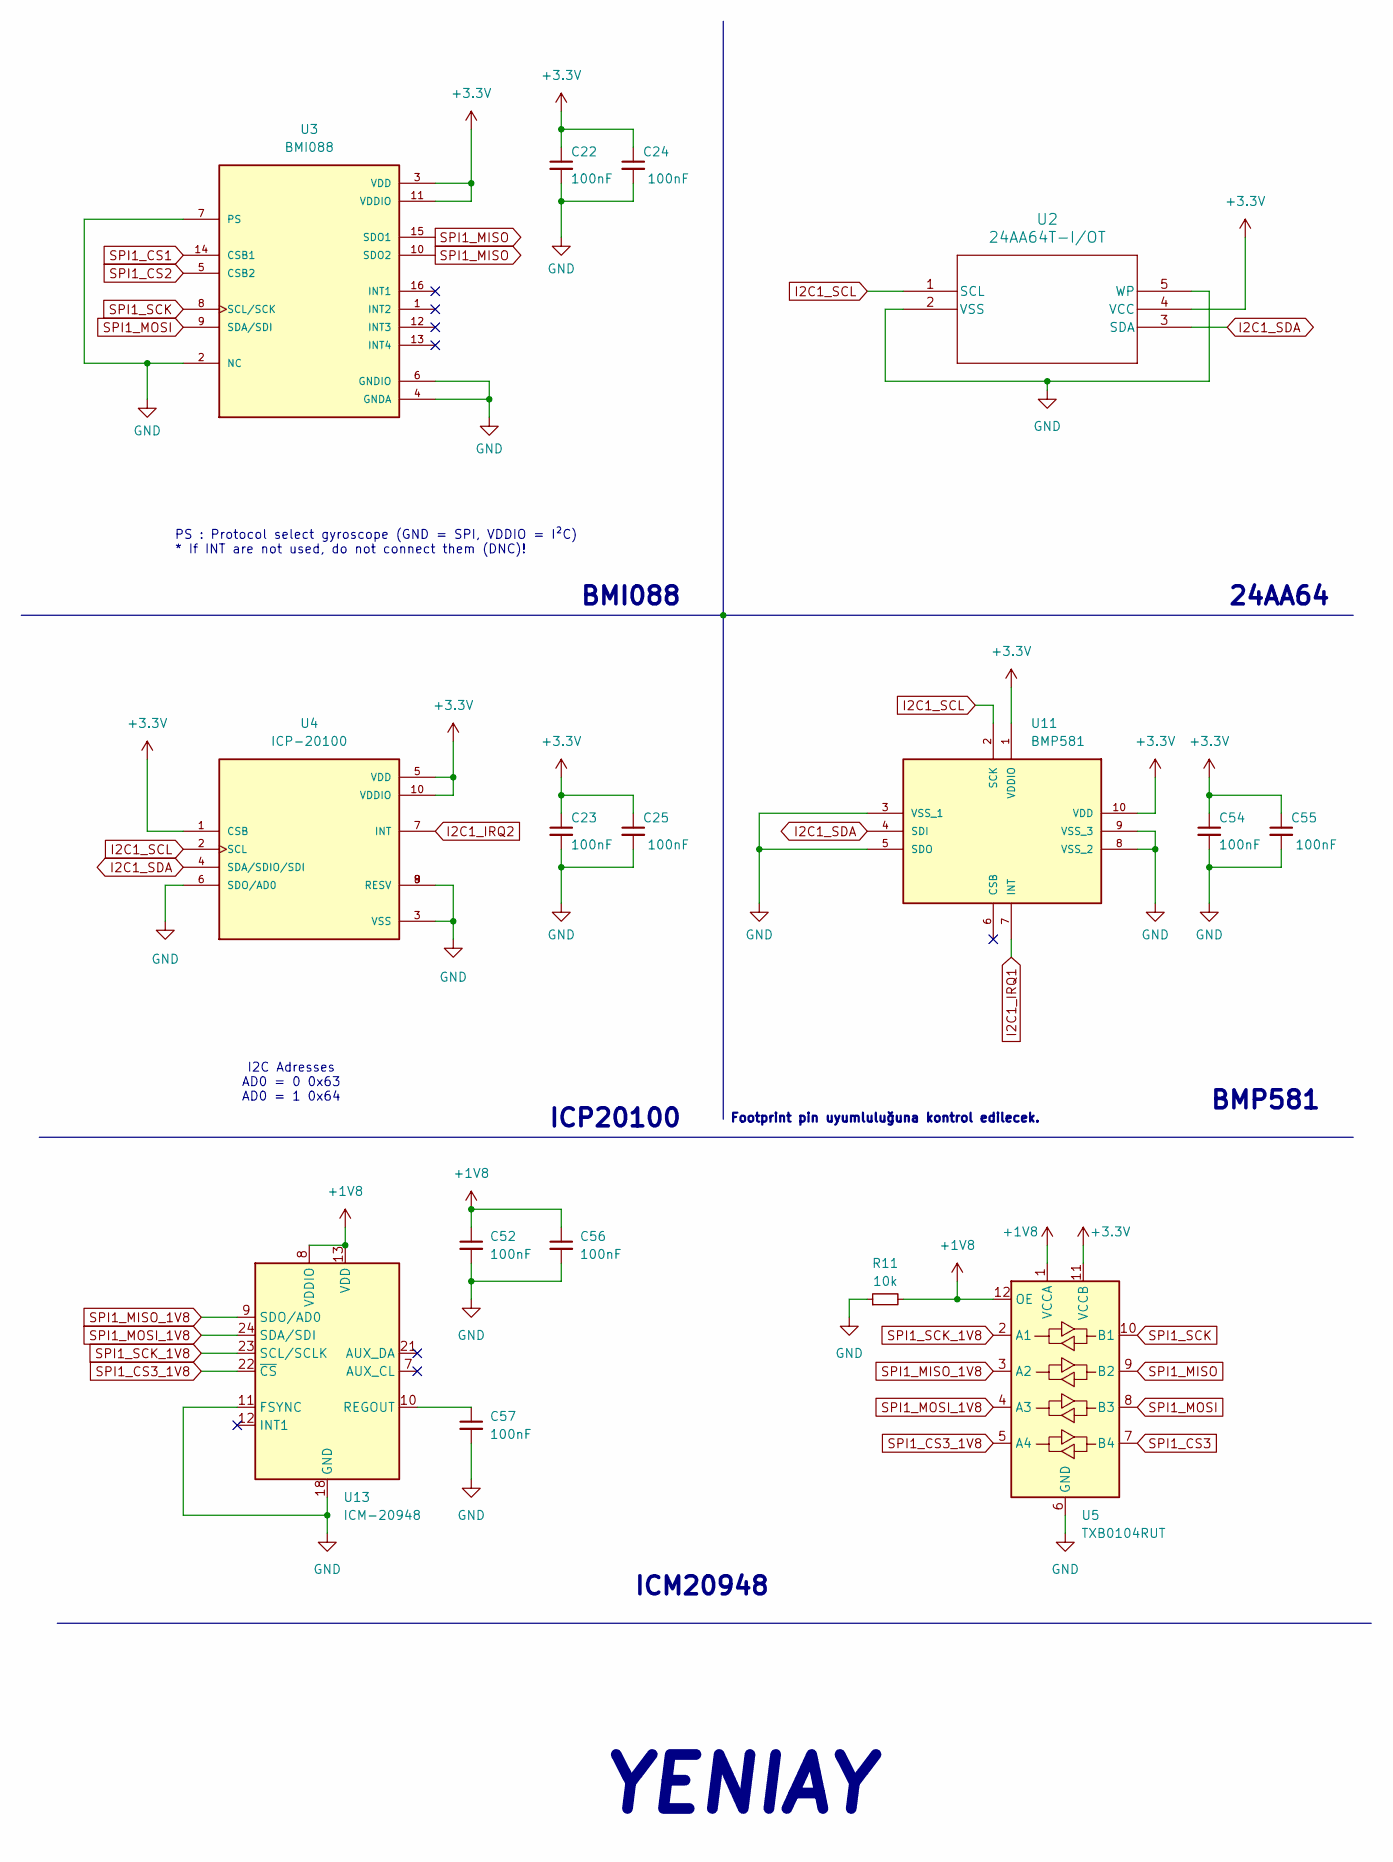
[picture p13: schematic Sensors.kicad_sch]

Parts:
C22, C23, C24, C25, C52, C54, C55, C56, C57: 100nF; C_0402_1005Metric
R11: 10k; R_0402_1005Metric
U2: 24AA64T-I/OT; SOT-23-5_HandSoldering
U3: BMI088; PQFN50P450X300X100-16N
U4: ICP-20100; PQFN50P200X200X85-10N; PARTREV 1.1
U5: TXB0104RUT; Texas_R-PUQFN-N12
U11: BMP581; Manufacturer_Part_Number BMP581
U13: ICM-20948; InvenSense_QFN-24_3x3mm_P0.4mm

Connections:
+1V8: C52.1, C56.1, R11.2, U5.1 (VCCA), U5.12 (OE), U13.8 (VDDIO), U13.13 (VDD); also elsewhere on the board
+3.3V: C22.1, C23.1, C24.1, C25.1, C54.1, C55.1, U2.4 (VCC), U3.3 (VDD), U3.11 (VDDIO), U4.1 (CSB), U4.5 (VDD), U4.10 (VDDIO), U5.11 (VCCB), U11.1 (VDDIO), U11.10 (VDD); also elsewhere on the board
GND: C22.2, C23.2, C24.2, C25.2, C52.2, C54.2, C55.2, C56.2, C57.2, R11.1, U2.2 (VSS), U2.5 (WP), U3.2 (NC), U3.4 (GNDA), U3.6 (GNDIO), U3.7 (PS), U4.3 (VSS), U4.6 (SDO/AD0), U4.8 (RESV), U4.9 (RESV), U5.6 (GND), U11.3 (VSS_1), U11.5 (SDO), U11.8 (VSS_2), U11.9 (VSS_3), U13.11 (FSYNC), U13.18 (GND), U13.20 (GND); also elsewhere on the board
I2C1_IRQ1: U11.7 (INT); also elsewhere on the board
I2C1_IRQ2: U4.7 (INT); also elsewhere on the board
I2C1_SCL: U2.1 (SCL), U4.2 (SCL), U11.2 (SCK); also elsewhere on the board
I2C1_SDA: U2.3 (SDA), U4.4 (SDA/SDIO/SDI), U11.4 (SDI); also elsewhere on the board
unnamed: C57.1, U13.10 (REGOUT)
SPI1_CS1: U3.14 (CSB1); also elsewhere on the board
SPI1_CS2: U3.5 (CSB2); also elsewhere on the board
SPI1_CS3: U5.7 (B4); also elsewhere on the board
SPI1_CS3_1V8: U5.5 (A4), U13.22 (~CS)
SPI1_MISO: U3.10 (SDO2), U3.15 (SDO1), U5.9 (B2); also elsewhere on the board
SPI1_MISO_1V8: U5.3 (A2), U13.9 (SDO/AD0)
SPI1_MOSI: U3.9 (SDA/SDI), U5.8 (B3); also elsewhere on the board
SPI1_MOSI_1V8: U5.4 (A3), U13.24 (SDA/SDI)
SPI1_SCK: U3.8 (SCL/SCK), U5.10 (B1); also elsewhere on the board
SPI1_SCK_1V8: U5.2 (A1), U13.23 (SCL/SCLK)

Notes on the sheet:
YENIAY
BMP581
ICM20948
24AA64
Footprint pin uyumluluğuna kontrol edilecek.
ICP20100
I2C Adresses AD0 = 0 0x63 AD0 = 1 0x64
PS : Protocol select gyroscope (GND = SPI, VDDIO = I²C) * If INT are not used, do not connect them (DNC)!
BMI088

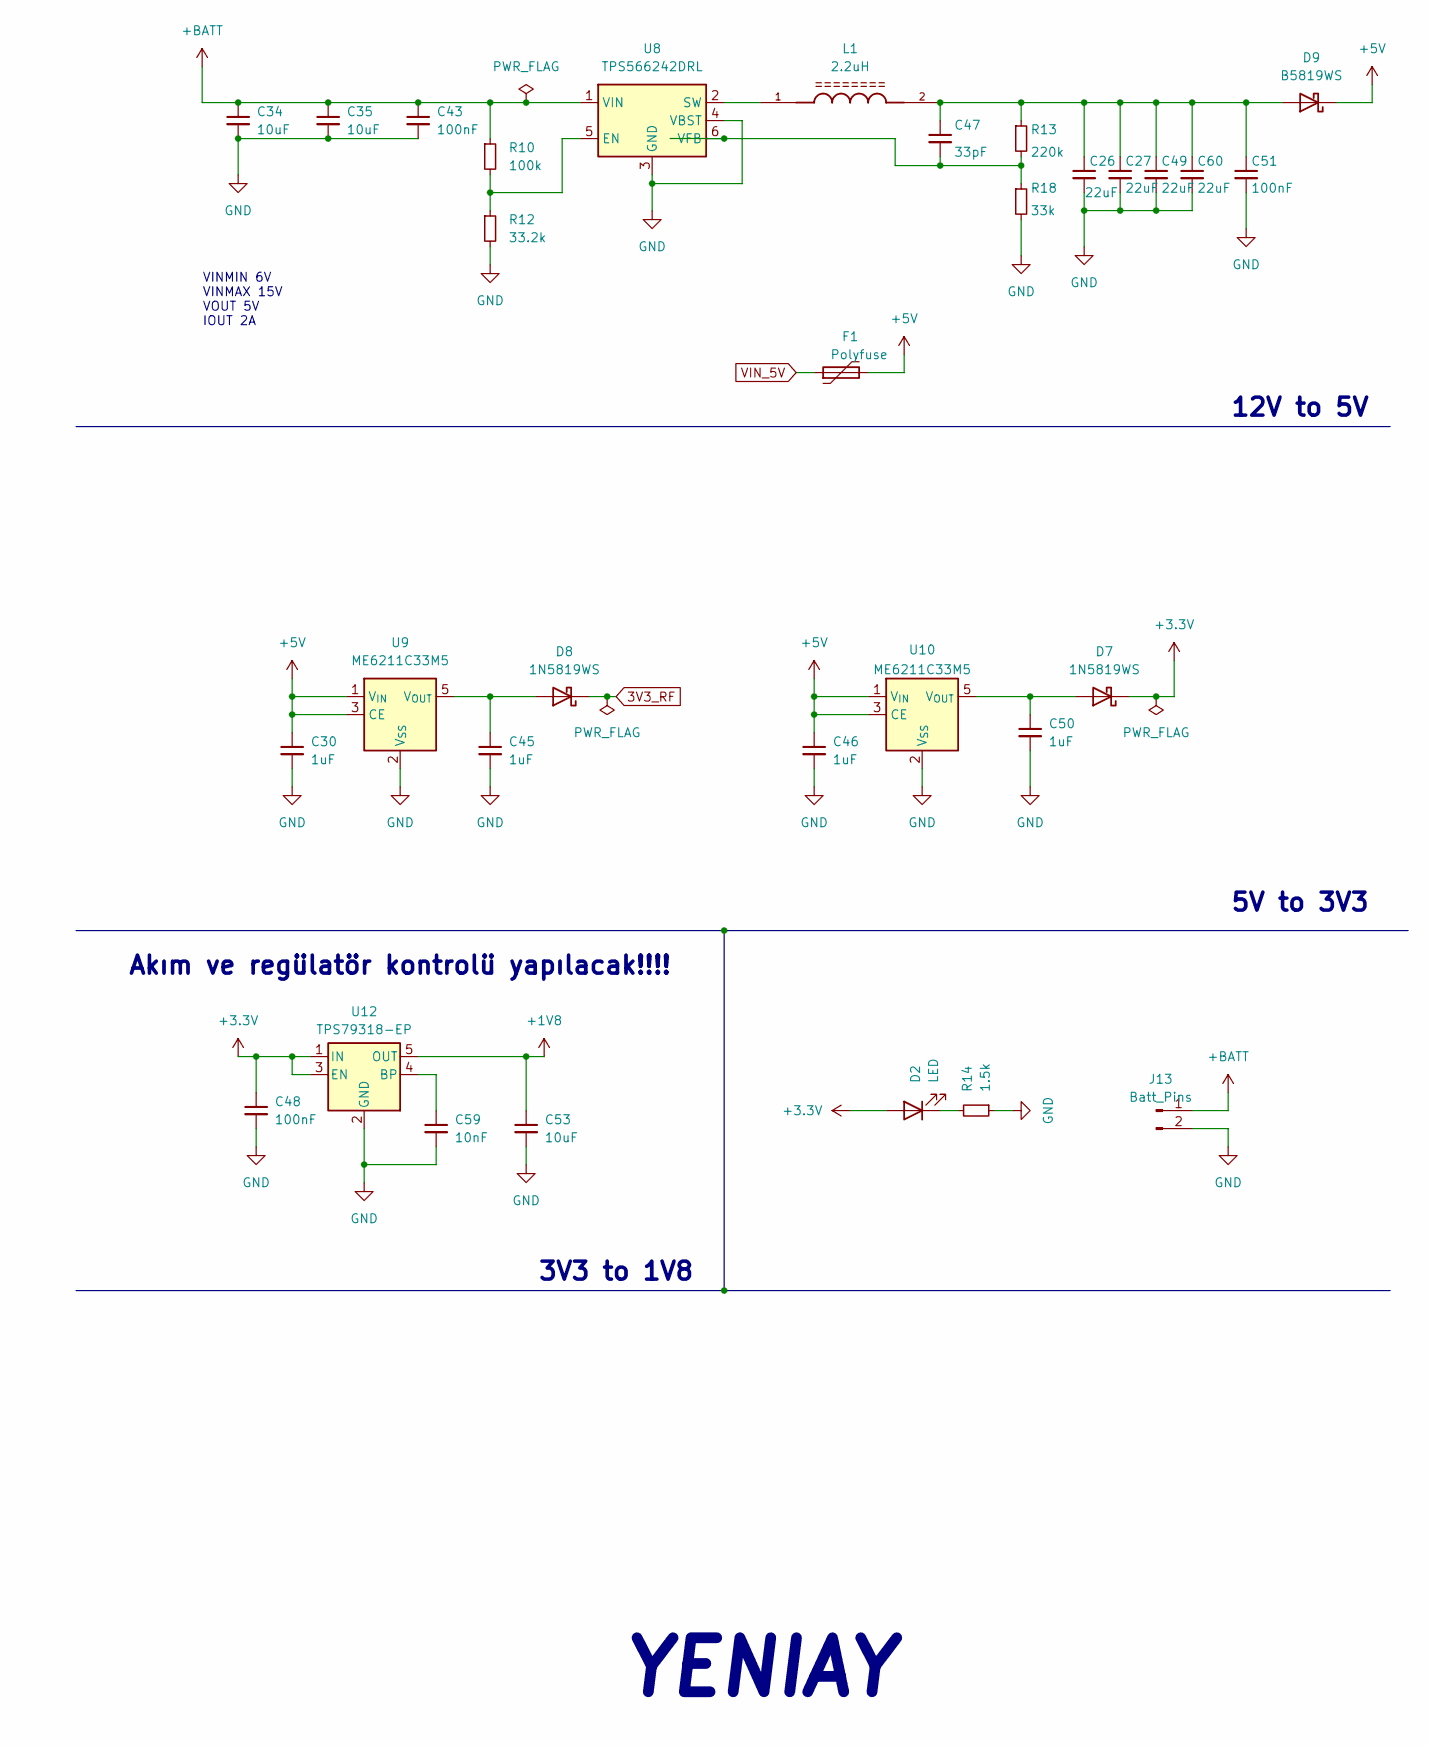
[picture p14: schematic Power.kicad_sch, POWER SECTION]

Parts:
C26, C27, C49, C60: 22uF; C_0805_2012Metric
C30, C45, C46, C50: 1uF; C_0805_2012Metric
C34, C35: 10uF; C_0805_2012Metric
C43, C48: 100nF; C_0402_1005Metric
C47: 33pF; C_0402_1005Metric
C51: 100nF; C_0603_1608Metric
C53: 10uF; C_0603_1608Metric
C59: 10nF; C_0402_1005Metric
D2: LED; LED_0603_1608Metric
D7, D8: 1N5819WS; D_SOD-323
D9: B5819WS; D_SOD-323
F1: Polyfuse; Fuse_0805_2012Metric
J13: Batt_Pins; PinSocket_1x02_P2.54mm_Vertical
L1: 2.2uH; IND_SRN6045TA-2R2Y
R10: 100k; R_0603_1608Metric
R12: 33.2k; R_0603_1608Metric
R13: 220k; R_0603_1608Metric
R14: 1.5k; R_0402_1005Metric
R18: 33k; R_0603_1608Metric
U8: TPS566242DRL; SOT-563
U9, U10: ME6211C33M5; SOT-23-5
U12: TPS79318-EP; SOT-23-5

Connections:
3V3_RF: D8.1 (K); also elsewhere on the board
+1V8: C53.1, U12.5 (OUT); also elsewhere on the board
+3.3V: C48.1, D2.2 (A), D7.1 (K), U12.1 (IN), U12.3 (EN); also elsewhere on the board
+5V: C30.1, C46.1, D9.1 (K), F1.2, U9.1 (V_{IN}), U9.3 (CE), U10.1 (V_{IN}), U10.3 (CE); also elsewhere on the board
+BATT: C34.1, C35.1, C43.1, J13.1, R10.1, U8.1 (VIN)
GND: C26.2, C27.2, C30.2, C34.2, C35.2, C43.2, C45.2, C46.2, C48.2, C49.2, C50.2, C51.2, C53.2, C59.2, C60.2, J13.2, R12.2, R14.1, R18.2, U8.3 (GND), U8.4 (VBST), U9.2 (V_{SS}), U10.2 (V_{SS}), U12.2 (GND); also elsewhere on the board
unnamed: D2.1 (K), R14.2
unnamed: C50.1, D7.2 (A), U10.5 (V_{OUT})
unnamed: C45.1, D8.2 (A), U9.5 (V_{OUT})
unnamed: C26.1, C27.1, C47.1, C49.1, C51.1, C60.1, D9.2 (A), L1.2, R13.1
unnamed: R10.2, R12.1, U8.5 (EN)
unnamed: L1.1, U8.2 (SW)
unnamed: C47.2, R13.2, R18.1, U8.6 (VFB)
unnamed: C59.1, U12.4 (BP)
VIN_5V: F1.1; also elsewhere on the board

Notes on the sheet:
YENIAY
3V3 to 1V8
VINMIN 6V VINMAX 15V VOUT 5V IOUT 2A
12V to 5V
5V to 3V3
Akım ve regülatör kontrolü yapılacak!!!!
