OzanE1/CCM7A/CC_M7/CC_M7.kicad_pcb

## KiCad design CC_M7/CC_M7.kicad_pcb (continued)

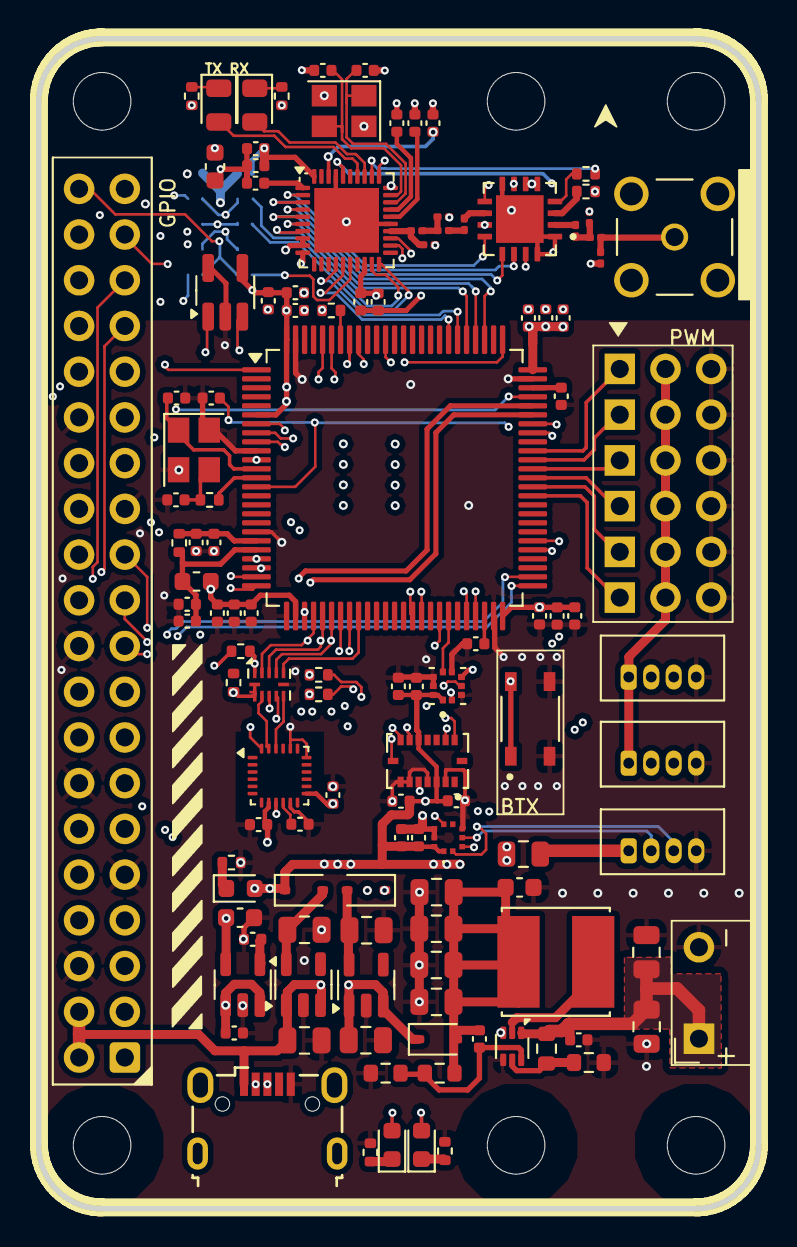
[picture p15: board CC_M7.kicad_pcb from above]

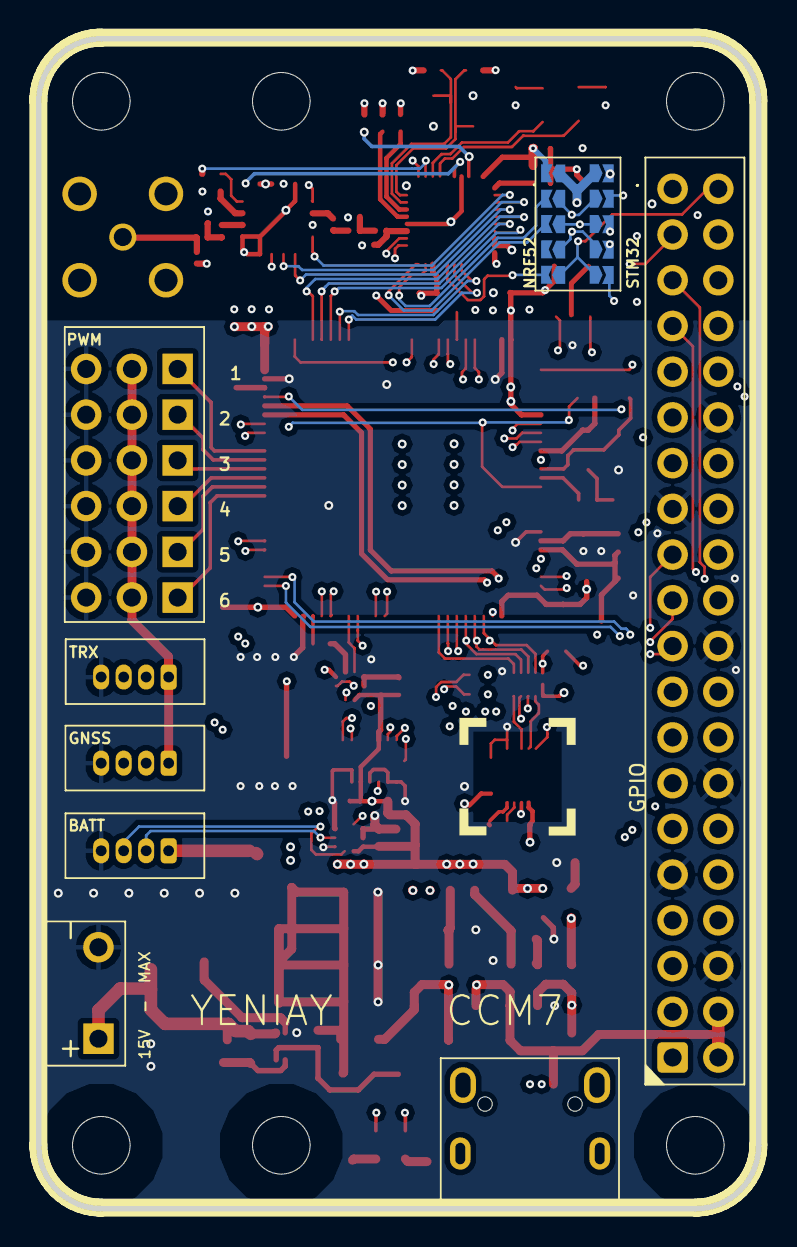
[picture p16: board CC_M7.kicad_pcb from below]

Board: 4 copper layers, 40.0 x 65.0 mm, 140 parts (10 on the bottom side), 112 nets.
