OzanE1/CCM7A/(commit log)

2025-05-09 add files.
    [Antenna.kicad_pcb, Antenna.kicad_sch, BMI088.kicad_pcb, BMI088.kicad_sch, BMM150.kicad_pcb, BMM150.kicad_sch, BMP388.kicad_pcb, BMP388.kicad_sch]
2025-05-09 New regulator tps566242DRL
    [Power.kicad_sch]
2025-05-09 Scehmatic completed.
    [CC_M7.kicad_pcb, ControlComputer.kicad_sch, Power.kicad_sch, RF Telemetry.kicad_sch, Sensors.kicad_sch]
2025-05-09 last control
    [Connections.kicad_sch, ControlComputer.kicad_sch, RF Telemetry.kicad_sch]
2025-05-11 ready for routing
    [CC_M7.kicad_pcb, CC_M7.kicad_sch, ControlComputer.kicad_sch, Power.kicad_sch, RF Telemetry.kicad_sch, Sensors.kicad_sch]
2025-05-11 ready to routing
    [CC_M7.kicad_pcb, Connections.kicad_sch, ControlComputer.kicad_sch]
2025-05-11 ready final
    [CC_M7.kicad_pcb]
2025-05-12 Routing in progress
    [CC_M7.kicad_pcb]
2025-05-12 Inductor added.
    [CC_M7.kicad_pcb, Power.kicad_sch]
2025-05-13 CCM7A Routing in progress.
    [CC_M7.kicad_pcb, CC_M7.kicad_sch, Connections.kicad_sch, ControlComputer.kicad_sch, Power.kicad_sch, RF Telemetry.kicad_sch, Sensors.kicad_sch]
2025-05-13 regülatör devresi güvenli kullanıma uygun hale getirildi.
    [CC_M7.kicad_pcb, CC_M7.kicad_sch, Connections.kicad_sch, ControlComputer.kicad_sch, Power.kicad_sch, RF Telemetry.kicad_sch, Sensors.kicad_sch]
2025-05-13 CCM7A BIG ROUTING PROGRESS
    [CC_M7.kicad_pcb, CC_M7.kicad_sch, Connections.kicad_sch, ControlComputer.kicad_sch, Power.kicad_sch, RF Telemetry.kicad_sch, Sensors.kicad_sch]
2025-05-15 error check
    [CC_M7.kicad_pcb]
2025-05-18 Debugging routes added. / Debug footprint updated.
    [CC_M7.kicad_pcb, ControlComputer.kicad_sch, RF Telemetry.kicad_sch]
2025-05-18 bom added
    [Sample-BOM_JLCSMT.xlsx]
2025-05-19 Routing Completed 0 Error
    [CC_M7.kicad_pcb]
2025-05-19 BOM finished.
    [CC_M7.kicad_pcb, CC_M7.kicad_sch, Connections.kicad_sch, ControlComputer.kicad_sch, Power.kicad_sch, RF Telemetry.kicad_sch, Sample-BOM_JLCSMT.xlsx, Sensors.kicad_sch]
2025-05-19 Rotation check completed.
    [CC_M7.kicad_pcb, Sample-BOM_JLCSMT.xlsx]
2025-05-24 Routing Update
    [CC_M7.kicad_pcb]
2025-05-25 last check
    [CC_M7.kicad_pcb, Connections.kicad_sch, ControlComputer.kicad_sch, RF Telemetry.kicad_sch, Sample-BOM_JLCSMT.xlsx]
2025-06-01 vias constraints changes
    [CC_M7.kicad_pcb]
2025-06-01 via correction completed
    [CC_M7.kicad_pcb]
2025-06-05 CCM7 Unconnected item routing progress.
    [CC_M7.kicad_pcb]
2025-06-26 pdf added
    [CCM7A-top_jlcpcb_v2.csv, CCM7A_BOM.xlsx, Connections.kicad_sch, Power.kicad_sch, RF Telemetry.kicad_sch, Sample-BOM_JLCSMT.xlsx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]
